Dreamdealer1-crypto/forceSensor_8x8/方案/8x8_压力矩阵_监工状态文档_v15.md

# 8×8织物压力矩阵逆向复现 —— 监工状态文档

> **唯一持续状态台账 / Single Source of Truth**  
> 监工：ChatGPT（GPT-5.6 Sol）  
> 执行者：Codex  
> 当前版本：v0.1  
> 当前日期：2026-08-15  
> 项目目标：先以8×8验证平台证实/证伪“阻性矩阵 + 零电位硬件解耦 + 每列TIA读出”路线，再对照原40×40样机，最终实现可证据闭环的100%复现。

---

## 1. 总体状态

**项目状态：IN PROGRESS**  
**当前阶段：ARCHITECTURE_EVALUATION —— 采集链已闭环，待稳定夹具复测 H1 传递函数**  
**当前结论等级：TIA / ADC3 / DMA / 软件采集链已验证正常；H1 失败归因于测试夹具接触不稳定，待稳定夹具复测。**

### 当前禁止事项
- 禁止直接进入STM32采集代码开发；
- 禁止接真实8×8传感器进行正式测试；
- 禁止改动已冻结4051控制引脚；
- 禁止改动ADC3八通道分配；
- 禁止把COL改接第二片4051；
- 禁止修改ROW 100 kΩ上拉、TIA Rf=10 kΩ、Cf=100 pF；
- 禁止未经监工批准更换VREF方案；
- 禁止在缺少RAW数据时仅凭热图宣布成功。

---

## 2. 当前冻结硬件基线

### STM32
- 主板：NUCLEO-H743ZI2
- MCU：STM32H743ZIT6
- ADC：ADC3单外设
- 调试串口：USART3 / ST-LINK VCP，初始115200 8N1

### 74HC4051（ROW）
- VCC → 3V3
- GND → GND
- VEE → GND
- Z / COM → GND
- S0 → PE14
- S1 → PE11
- S2 → PE9
- E / INH → **PG5**
- Y0~Y7 → ROW0~ROW7
- 每根ROW同时通过 **100 kΩ → VREF**

### VREF
- 3V3 → 2.2 kΩ → VREF
- VREF → 1 kΩ → GND
- VREF → 10 µF → GND
- VREF → 100 nF → GND
- 理论值约1.031 V
- 最终所有计算以实测VREF为准

### MCP6002 ×4（8路TIA）
每颗：
- Pin8 → 3V3
- Pin4 → GND
- Pin8/Pin4附近各自有100 nF去耦
- Pin3、Pin5 → VREF
- A路：Pin1 ↔ Pin2：10 kΩ ∥ 100 pF
- B路：Pin7 ↔ Pin6：10 kΩ ∥ 100 pF

### COL → ADC3固定映射
| COL | MCP6002输出 | STM32 | ADC3 |
|---|---|---|---|
| COL0 | U1 Pin1 | PF4 | INP9 |
| COL1 | U1 Pin7 | PF5 | INP4 |
| COL2 | U2 Pin1 | PF6 | INP8 |
| COL3 | U2 Pin7 | PF7 | INP3 |
| COL4 | U3 Pin1 | PF10 | INP6 |
| COL5 | U3 Pin7 | PC0 | INP10 |
| COL6 | U4 Pin1 | PC1 | INP11 |
| COL7 | U4 Pin7 | PC2 | INP12 |

---

## 3. 已知关键证据

### 原40×40系统
- 40×40阵列，80根经纬线独立引出；
- 原主控为STM32F407VET6；
- 上位机处理1600点矩阵；
- 原传感器ROW-COL之间外接标准电阻：
  - **10 kΩ：软件出现点**
  - **100 kΩ：软件点消失**

### 当前解释
该结果强烈支持“原系统对ROW-COL等效电导/阻抗变化敏感”，但**不能单凭该结果确认原系统就是纯电阻式或TIA读出**。软件阈值、基线或非线性映射仍可能参与。

---

## 4. Gate状态

| Gate | 内容 | 状态 | 关键证据 |
|---|---|---|---|
| H0 | 电源/VREF/TIA静态工作点 | **PASS** | 3V3=3.30V，VREF=1.03V，4颗MCP6002静态工作点用户报告正常 |
| H1 | 标准电阻传递函数 | **FAIL（归因测试夹具）** | 10k/22k有响应，47k/100k回VREF，R²=0.690449；已排除固件/DMA，待稳定夹具复测 |
| H2 | 4051 ROW扫描验证 | **PASS** | selected≈0V，unselected≈1.0V；偶发1.3V列为观察项 |
| ADC-01 | PF6 单通道 Polling | **PASS** | 1.143310 V，Rank1=Ch8，DMA=0 |
| ADC-02 | 8-rank Scan Polling | **PASS** | r3/c2=1.143634 V，SQR/PCSEL/DIFSEL 正确 |
| ADC-03A | 8-rank DMA 基线审计 | **NOT_REPRODUCED** | r3/c2=1.143236 V，read_before_tc=0，无 OVR/DMA 错 |
| H3 | 2×2有限电阻矩阵串扰A/B实验 | BLOCKED | 等H1/H2 PASS |
| H4 | 真实8×8传感器 | BLOCKED | 等H3 PASS |
| H5 | 参数优化 | BLOCKED | 等H4 PASS |
| O1 | 原40×40标准R扫值 | WAITING | 已有10k/100k两点证据 |
| O2 | 原40×40行列波形/模拟前端对照 | WAITING | 尚未测 |
| F1 | 40×40复刻设计 | BLOCKED | 必须等8×8与原机证据闭环 |

---

## 5. 当前第一道执行命令 —— 给Codex

### ORDER-001：H0静态硬件验收

**目的：在任何固件开发和传感器接入之前，证明模拟前端没有接线错误、饱和或VREF异常。**

### 执行要求
1. **不要接真实传感器。**
2. STM32仅上电，不要求先写扫描程序。
3. 使用万用表测量并记录：
   - STM32 3V3
   - VREF
   - U1 Pin3、Pin5
   - U2 Pin3、Pin5
   - U3 Pin3、Pin5
   - U4 Pin3、Pin5
   - U1 Pin1、Pin7
   - U2 Pin1、Pin7
   - U3 Pin1、Pin7
   - U4 Pin1、Pin7
4. 若有示波器，再观察：
   - VREF是否存在明显高频振荡；
   - 8个TIA输出是否存在振荡/贴轨。
5. 提交硬件照片，至少能看到：
   - 4051接线；
   - 4颗MCP6002；
   - 10k/100pF反馈；
   - VREF分压；
   - 每颗MCP6002的100nF去耦。

### 提交格式
Codex必须返回：

```text
ORDER-001 RESULT

3V3 = ___ V
VREF = ___ V

U1 Pin3 = ___ V
U1 Pin5 = ___ V
U1 Pin1 = ___ V
U1 Pin7 = ___ V

U2 ...
U3 ...
U4 ...

是否存在输出贴0V/3.3V：YES/NO
是否观察到明显振荡：YES/NO/未测

硬件照片：
<路径或附件>

异常：
<无 / 具体问题>
```

### H0 PASS条件
- 3V3正常；
- VREF约1.03 V且稳定；
- 所有MCP6002 Pin3/Pin5≈VREF；
- 无传感器输入时8个TIA输出均应位于VREF附近，不得长期贴0 V或3.3 V；
- 无明显短路、过热、异常电流或高频自激。

### H0 FAIL处理
若任一路异常：
- **停止后续开发；**
- 不允许通过软件滤波掩盖；
- 先由监工定位硬件问题并发出返工命令。

---

## 6. H0通过后的预定命令（尚未授权执行）

### ORDER-002：创建STM32工程
只有H0 PASS后下发：
- 固定GPIO；
- ADC3八通道regular sequence；
- USART3 VCP；
- 先做RAW输出；
- 不接真实传感器。

### ORDER-003：标准电阻传递函数
只有ORDER-002验收后下发：
- 10k、22k、47k、68k、100k、220k、470k、1M；
- 建立ADC/电压对1/R的传递函数；
- 验证平台是否能够稳定测R。

### ORDER-004：2×2零电位串扰A/B
只有H1/H2 PASS后下发：
- 有限非目标电阻；
- FLOAT vs 100k→VREF；
- 量化Kghost；
- 证实/证伪零电位解耦。

---

## 7. 监工判定原则

- “有数据” ≠ PASS；
- “能显示点” ≠ PASS；
- “热图看起来不错” ≠ PASS；
- 必须有RAW数据；
- 必须有对照组；
- 必须有重复性；
- 必须量化噪声/串扰；
- 必须区分硬件现象、固件处理和PC显示；
- 任何结论只能达到证据允许的强度。

---

## 8. 当前监工判断

### 技术判断
当前路线值得继续，但还没有证据证明：
- 原机一定使用TIA；
- 原机一定使用零电位法；
- 中间层一定是纯压阻；
- 8×8方案可以直接等比例扩展到40×40。

### 当前最高优先级
**先完成H0静态工作点验收。**

如果H0都不稳定，后面的ADC、算法、热图全部没有讨论价值。

---

## 9. 更新规则

今后每次Codex提交执行结果：
1. 监工先验收；
2. 给出 `PASS / FAIL / WAITING / 返工`；
3. 更新本文件Gate状态；
4. 记录关键证据；
5. 记录异常与风险；
6. 下发唯一下一条ORDER。

**未经监工验收，不跨Gate。**

---

## 10. 监工记录 #001 — Codex管理基线验收

**时间：2026-08-12 22:48 +08:00**  
**对应指令：ORDER-001**

### Codex提交
- Git仓库初始化完成；
- 管理基线提交：`3a3891c chore: initialize project management baseline`；
- `docs/STATUS.md` 已记录当前监工指令；
- `docs/DATA_MANAGEMENT.md` 已建立数据管理规范；
- `data/templates/gate_h0_static_measurement.csv` 已建立H0测量模板；
- 当前保持：不接真实传感器、不写扫描代码；
- Codex自报状态：`H0 WAITING_MEASUREMENT`。

### 监工验收
**管理动作：PASS**  
**H0 Gate：仍为 WAITING_MEASUREMENT**

理由：
- Codex没有越过Gate；
- 没有提前写扫描代码；
- 没有接真实传感器；
- 已建立可追溯的数据与状态管理基础；
- 但ORDER-001的核心证据——实际静态电压测量——尚未提交，因此不能判定H0 PASS。

### 当前唯一允许执行的下一步

#### ORDER-001A：完成H0静态测量
必须实测并提交：
- 3V3；
- VREF；
- U1 Pin3、Pin5、Pin1、Pin7；
- U2 Pin3、Pin5、Pin1、Pin7；
- U3 Pin3、Pin5、Pin1、Pin7；
- U4 Pin3、Pin5、Pin1、Pin7。

同时记录：
- 是否有任一路输出贴近0 V；
- 是否有任一路输出贴近3.3 V；
- 是否有芯片异常发热；
- 若有示波器，记录VREF和任一TIA输出是否存在明显振荡。

### 禁止事项继续有效
在ORDER-001A验收前：
- 禁止创建ADC3扫描逻辑；
- 禁止创建4051轮询扫描逻辑；
- 禁止接真实8×8传感器；
- 禁止调整Rf/Cf/VREF/ROW上拉参数；
- 禁止更改冻结引脚。

### 下一Gate条件
只有当ORDER-001A数据通过监工验收后，才允许下发：
`ORDER-002：STM32工程 + 4051 GPIO + ADC3八通道RAW采集`

---

## 11. 监工记录 #002 — H0静态工作点验收

**时间：2026-08-12 23:04 +08:00**  
**对应指令：ORDER-001A**

### 用户实测
- 3V3 = **3.30 V**
- VREF = **1.03 V**
- U1 Pin3 / Pin5 / Pin1 / Pin7：用户报告 **正常**
- U2 Pin3 / Pin5 / Pin1 / Pin7：用户报告 **正常**
- U3 Pin3 / Pin5 / Pin1 / Pin7：用户报告 **正常**
- U4 Pin3 / Pin5 / Pin1 / Pin7：用户报告 **正常**

### 监工判定
**H0：PASS**

判定依据：
- 3V3符合预期；
- VREF与理论1.031 V高度一致；
- 4颗MCP6002的正输入与输出均未报告贴轨、异常或明显故障；
- 已满足进入数字控制与ADC RAW采集阶段的最低硬件条件。

### 证据质量备注
用户未逐路给出8个TIA输出的具体数值，因此本次H0属于“功能性PASS”。  
后续ORDER-002在ADC3 RAW采集时必须补回8路空载基线数值，以再次确认所有TIA输出确实位于合理工作点。

---

## 12. 当前执行命令 —— ORDER-002

### 目标
建立最小STM32固件，只验证：
1. 4051行选择；
2. ADC3八通道RAW采集；
3. 串口原始输出；
4. 不接真实传感器；
5. 不做压力换算、不做滤波、不做热图。

### Codex必须执行

#### A. GPIO
固定：
- S0 = PE14
- S1 = PE11
- S2 = PE9
- E  = PG5

要求：
- Push-Pull Output
- 初始 `E=1`（4051关闭）
- 提供 `row_select(uint8_t row)` 函数
- 切换流程必须：`E=1 → 写S0/S1/S2 → 短延迟 → E=0`

#### B. ADC3
固定8个输入，Rank顺序必须严格为COL0→COL7：
1. PF4  / ADC3_INP9
2. PF5  / ADC3_INP4
3. PF6  / ADC3_INP8
4. PF7  / ADC3_INP3
5. PF10 / ADC3_INP6
6. PC0  / ADC3_INP10
7. PC1  / ADC3_INP11
8. PC2  / ADC3_INP12

要求：
- 仅使用ADC3；
- Regular Sequence 8 ranks；
- DMA；
- 首版采用保守采样时间；
- 上电执行ADC校准；
- 首版软件触发；
- 禁止启用复杂数字滤波/oversampling以免掩盖模拟问题。

#### C. 扫描时序
首版：
- `T_SETTLE_US = 500`
- 每个ROW：
  - 选择ROW
  - 等待500 µs
  - 做1次8通道dummy scan并丢弃
  - 再做16次8通道scan
  - 计算每列平均RAW ADC
- 扫完8行后 `E=1`

#### D. 串口
优先USART3 / ST-LINK VCP：
- 115200
- 8N1

每帧文本输出：
`FRAME,<seq>,<timestamp_us>`
然后：
`R0,c0,c1,c2,c3,c4,c5,c6,c7`
...
`R7,c0,c1,c2,c3,c4,c5,c6,c7`
最后：
`END`

禁止当前阶段输出“压力值”。

### ORDER-002验收前禁止
- 禁止接真实8×8传感器；
- 禁止做H1标准电阻；
- 禁止改Rf/Cf/VREF；
- 禁止改GPIO/ADC3 pin map；
- 禁止加入热图或阈值算法。

### Codex提交必须包含
1. Git commit hash；
2. `.ioc`；
3. GPIO配置；
4. ADC3 Rank 1~8配置；
5. ADC分辨率与sampling time；
6. DMA配置；
7. 编译日志；
8. 烧录日志；
9. 串口至少连续5帧RAW输出；
10. 8路空载ADC基线均值与标准差。

### ORDER-002判定
- GPIO、ADC3、DMA、UART均按冻结方案：必要条件；
- 8路数据顺序稳定，无通道丢失；
- ADC无固定0/满量程异常；
- 8路空载RAW能对应到合理的TIA静态工作点；
- 连续帧无明显错位/丢列。

满足后才允许进入H1标准电阻传递函数。

---

## 13. 监工记录 #003 — ORDER-002 固件与空载ADC验收

**时间：2026-08-12 23:20 +08:00**  
**Codex提交 commit：`996390cbc553ba3c0314e55ea963786c3f1bd5e7`**

### 交付物
- `.ioc`：`firmware/8x8_resist_matrix_minimal.ioc`
- 主程序：`firmware/Core/Src/main.c`
- 构建日志：`reports/logs/2026-08-12_order-002_build.log`
- 烧录日志：`reports/logs/2026-08-12_order-002_flash.log`
- 5帧RAW串口：`data/raw/2026-08-12_order-002_raw_uart_5frames_run01.log`
- ADC统计：`data/analysis/2026-08-12_order-002_unloaded_adc_stats_run01.csv`
- 监工回复：`reports/supervisor/2026-08-12_order-002_minimal-firmware-result.md`

### 固件配置核对
- GPIO：S0=PE14，S1=PE11，S2=PE9，E=PG5；
- ADC3单外设；
- Rank 1~8严格对应COL0~COL7；
- 16-bit ADC；
- Sampling time = `ADC_SAMPLETIME_64CYCLES_5`；
- DMA1_Stream1 / DMA_REQUEST_ADC3 / DMA_NORMAL / halfword；
- USART3 = 115200 8N1；
- `T_SETTLE_US = 500`；
- 每ROW：1次dummy + 16次平均；
- 未接真实传感器；
- 未做热图和压力换算。

### 构建与运行
- Build：PASS；
- Flash：PASS；
- 串口：FRAME 0~4正常输出。

### 空载ADC统计
| COL | mean[count] | std[count] | 按3.3V满量程估算均值[V] | 估算噪声σ[mV] |
|---|---:|---:|---:|---:|
| COL0 | 20612.025 | 16.318 | 1.0379 | 0.82 |
| COL1 | 20622.950 | 28.258 | 1.0385 | 1.42 |
| COL2 | 20879.750 | 67.457 | 1.0514 | 3.40 |
| COL3 | 20751.750 | 31.360 | 1.0449 | 1.58 |
| COL4 | 20600.375 | 37.626 | 1.0373 | 1.89 |
| COL5 | 20628.625 | 20.656 | 1.0387 | 1.04 |
| COL6 | 20607.150 | 23.996 | 1.0377 | 1.21 |
| COL7 | 20615.750 | 22.663 | 1.0381 | 1.14 |

> 电压换算只用于工程判断，按ADC参考约3.3V估算；正式标定仍需使用实测参考。

### 监工分析
1. 8路均处在约1.04V附近，与实测VREF=1.03V一致，没有贴0V或3.3V，说明TIA静态工作点整体合理。
2. ADC3八通道、DMA、USART3及数据顺序已具备继续实验的基础。
3. COL2为当前异常关注通道：
   - 均值较其他通道高约13mV；
   - 标准差约3.4mV，为8路最大；
   - 目前不判FAIL，但必须在标准电阻实验中重点观察是否为固定通道噪声/接线问题。
4. 当前数据只能证明ADC/TIA空载链路基本可用，**不能证明4051实际选中ROW已经被正确拉到GND、未选中ROW被100k稳定在VREF**。
5. 因此ORDER-002的软件部分通过，但H2电气ROW扫描证据尚缺。

### 监工判定
- **C0/C2 最小固件与ADC RAW采集：PASS**
- **H2 4051 ROW电气扫描：WAITING_MEASUREMENT**
- **H1 标准电阻传递函数：仍 BLOCKED**

---

## 14. 当前唯一执行命令 —— ORDER-002A

### 目的
补齐4051实际电气动作证据，防止“代码在切ROW，但硬件ROW没有按预期到0V/VREF”。

### 执行方式
Codex增加一个**仅用于H2验证的静态/慢速ROW测试模式**：

- 每2秒切换一次ROW；
- 串口打印当前ROW编号；
- 顺序ROW0→ROW7循环；
- 其余ADC逻辑不改；
- 不接真实传感器。

用户用万用表或示波器测：
1. 当前被选中的ROW电压；
2. 任意一个未被选中的ROW电压。

至少记录：
- ROW0被选中时：ROW0、ROW1；
- ROW1被选中时：ROW1、ROW0；
- ROW7被选中时：ROW7、ROW0。

### 预期
- selected ROW：明显接近0V；
- unselected ROW：明显接近VREF≈1.03V。

### 提交
Codex/用户提交：
```text
ROW0 selected:
  ROW0 = __ V
  ROW1 = __ V

ROW1 selected:
  ROW1 = __ V
  ROW0 = __ V

ROW7 selected:
  ROW7 = __ V
  ROW0 = __ V
```

如果有示波器，补一张ROW切换波形。

### Gate
- 若selected≈0V、unselected≈VREF：H2 PASS，授权H1；
- 若不符合：H2 FAIL，先修4051/ROW网络，不得进入标准电阻实验。

---

## 15. 监工记录 #004 — H2 4051 ROW电气扫描验收

**时间：2026-08-12 23:35 +08:00**

### 用户实测
- ROW0 selected：
  - ROW0 ≈ 0 V
  - ROW1 ≈ 1.0 V
- ROW1 selected：
  - ROW1 ≈ 0 V
  - ROW0 ≈ 1.0 V
- ROW7 selected：
  - ROW7 ≈ 0 V
  - ROW0 ≈ 1.0 V

补充现象：
- 未选中ROW大部分时间约1.0 V；
- 偶尔观察到约1.3 V；
- 当前测量为大概值，未使用示波器做瞬态捕获。

### 监工判定
**H2：PASS（带观察项）**

依据：
- selected ROW稳定表现为约0 V；
- unselected ROW大部分时间接近VREF≈1.03 V；
- 说明4051选择逻辑、Z→GND和ROW 100 kΩ→VREF拓扑整体按预期工作。

### 观察项
偶发约1.3 V暂不阻塞：
- 可能来自切换瞬态、数字万用表采样/保持方式、寄生电容或VREF局部动态；
- 后续如果标准电阻实验出现明显离散、过冲或通道相关异常，再要求示波器测ROW切换波形。

### Gate变化
- H2：PASS
- H1：AUTHORIZED

---

## 16. 当前执行命令 —— ORDER-003：标准电阻传递函数

### 目的
验证整个链路：
`ROW选择 → 标准R → COL TIA → ADC3 → RAW`

是否能稳定、单调、可定量地测量已知电阻。

### 硬件
- **仍然不接真实8×8传感器。**
- 在 `ROW0 ↔ COL0` 之间接标准电阻。
- 其他ROW/COL不额外接矩阵电阻，保持当前硬件基线不变。

### 标准阻值
依次：
- 10 kΩ
- 22 kΩ
- 47 kΩ
- 68 kΩ
- 100 kΩ
- 220 kΩ
- 470 kΩ
- 1 MΩ

若有4.7 kΩ，可附加测试是否进入饱和，但不纳入主拟合。

### 每个阻值
- 连续采集至少100帧；
- 保存完整RAW；
- 重点提取 `R0,C0`；
- 同时记录其余63点，作为异常/鬼影参考，但本Gate不以鬼影为主要结论；
- 记录实测VREF。

### Codex必须输出
文件：
- `data/raw/...order-003_<R>_run01.log`
- `data/analysis/...order-003_transfer.csv`
- `reports/...order-003_transfer_result.md`
- 至少一张 `ΔV vs 1/R` 拟合图

统计字段至少包含：
- R_test_ohm
- raw_mean
- raw_std
- vout_mean_v
- delta_v = vout_mean - VREF
- inv_r
- theoretical_delta_v
- relative_error
- saturated
- R²（只对未饱和有效区拟合）

### 理论基线
当前：
- VREF ≈ 1.03 V
- Rf = 10 kΩ

理想：
`ΔV ≈ VREF × Rf / Rtest`

预期量级：
- 10 kΩ：ΔV≈1.03 V
- 22 kΩ：≈0.47 V
- 47 kΩ：≈0.22 V
- 100 kΩ：≈0.10 V
- 220 kΩ：≈47 mV
- 470 kΩ：≈22 mV
- 1 MΩ：≈10 mV

### PASS判据
强PASS：
- 10 kΩ~220 kΩ范围严格单调；
- 不出现随机0/满量程跳变；
- `ΔV vs 1/R` 的 R² ≥ 0.995；
- 10 kΩ~220 kΩ整体理论偏差≤5%为优良；
- 470 kΩ / 1 MΩ主要用于评估高阻区噪声，不以5%作为硬性门槛。

### 特别观察
- COL2此前空载std最高，本轮同时观察其余通道是否仍存在异常噪声；
- 若R0C0标准R数据正常而其他通道噪声不影响测量，不阻塞；
- 若标准R本身无法形成稳定单调传递函数，H1直接FAIL，不得接真实传感器。

---

## 17. 监工记录 #005 — ORDER-003 Run01 失败与加速返工方案

**时间：2026-08-13 00:12 +08:00**

### Codex提交
ORDER-003 Run01结果：`FAIL_REWORK_REQUIRED`

关键数据：
- 10k：Vout≈1.03797 V，理论≈2.06 V
- 22k：Vout≈1.03779 V
- 47k：Vout≈1.03794 V
- 68k：Vout≈1.03777 V
- 100k：Vout≈1.03782 V
- 220k：Vout≈1.03808 V
- 470k：Vout≈1.03803 V
- 1.5M：Vout≈1.03793 V
- 全阻值几乎不随R变化，说明标准R没有进入有效TIA电流路径。
- 1M缺失改用1.5M：**允许**。
- 10k/22k只有99帧：记录为次要问题，不是本轮失败主因。

### 监工判定
**H1：FAIL — 原因定位阶段**
不是算法问题，也不是采样帧数问题。
当前最可能为：
1. ROW0/COL0物理节点接错；
2. COL0没有接到U1 Pin2；
3. TIA反馈路径断路/接错；
4. 标准R没有真正跨接“0V选中ROW ↔ VREF虚地COL”。

### 加速原则
由于用户次日有紧急汇报，停止完整8阻值扫值，改为最小故障树。
只做能最大化信息增益的测试，不做重复性和完整统计。

---

## 18. 当前执行命令 —— ORDER-003A FAST DEBUG

### 目标
在最少手工测量下，今天内判断故障位于：
- TIA本身；
- COL0映射；
- ROW0/4051路径。

### Codex动作
增加一个 `FAST_DEBUG_ROW0` 模式：
- 4051固定选择ROW0；
- E保持有效；
- 不进行8行轮询；
- ADC3仍持续采8路；
- USART3每100ms打印一次8路RAW；
- 不做平均以外的算法处理。

### 用户只需做两步

#### FAST-A：绕过ROW/4051，直接验证TIA
不接真实传感器。

将 **10 kΩ** 直接接在：
- 一端：`U1 Pin2 / COL0 TIA反相输入节点`
- 另一端：`GND`

预期：
- U1 Pin1 / COL0 ADC输出应从约1.03 V升到约2.06 V；
- ADC COL0应显著升高；
- 其他COL基本不变。

判定：
- 若成立 → TIA0与ADC COL0链路PASS，故障在ROW0/4051/物理节点映射；
- 若不成立 → TIA0接线/反馈/ADC映射有问题，停止后续。

#### FAST-B：验证ROW0路径
只有FAST-A PASS后：
- 移除“COL0→10k→GND”
- 改为 `ROW0 ↔ 10 kΩ ↔ COL0`
- 运行固定ROW0模式

预期：
- U1 Pin1仍应约2.06 V；
- 若FAST-A PASS但FAST-B FAIL，则问题锁定在ROW0物理线、Y0/4051或ROW0标识。

### 今天若FAST-A/B都PASS
立即做最小4点传递函数：
- 10k
- 22k
- 47k
- 100k

每点只需30帧。
目标只证明：
- 单调；
- 数量级合理；
- 与1/R趋势一致。

这4点足够用于次日阶段汇报，但不得宣称完成完整H1。

### 汇报可用结论
截至当前可安全汇报：
1. 已完成8×8零电位/TIA采集平台硬件；
2. H0电源与8路TIA静态工作点通过；
3. 4051行选择：selected≈0V，unselected≈1.0V，H2通过；
4. ADC3八通道DMA与串口RAW链路通过；
5. 空载8路输出约1.04V，噪声约0.8~3.4mV RMS；
6. 首轮标准R实验失败，但失败模式非常明确：输出完全不随R变化，已排除“只是噪声太大”，当前在定位物理路径；
7. 当前已建立最小故障树FAST-A/B，可在不接真实传感器情况下区分TIA故障与ROW/4051映射故障。

### Gate状态
- H0：PASS
- H2：PASS
- H1：FAIL_REWORK
- H3/H4：BLOCKED

---

## 19. 监工记录 #006 — ORDER-003A FAST-A 验收

**时间：2026-08-13 00:22 +08:00**  
**Codex commit：`318bfc8438c9477ad5516f09417ece6b73802958`**

### FAST-A条件
- 固定ROW0；
- 10 kΩ直接跨接 `U1 Pin2 / COL0 TIA反相输入 ↔ GND`；
- 绕过4051/ROW物理路径；
- 未接真实传感器；
- ADC3每100 ms输出8路RAW。

### 实测
- COL0 mean = 38215.75 raw
- 按3.3 V满量程估算：Vout ≈ 1.924 V
- 原空载：≈1.038 V
- 实际输出变化：ΔV ≈ 0.886 V

### 监工判定
**FAST-A：PASS**

已确认：
1. U1A TIA能够响应外部电阻电流；
2. COL0 → ADC3 Rank1链路正常；
3. ORDER-003 Run01的“全阻值平坦”不是因为COL0 ADC死通道；
4. 故障范围已显著收缩到ROW0/4051/物理ROW-COL接点或标准电阻接入位置。

### 精度观察项
理论理想值约2.06 V，实际约1.924 V，低约0.14 V（约13%增量误差）。

当前不阻塞FAST-B，原因：
- FAST-A的目标是验证TIA/ADC链路是否有效，已经明确有效；
- 当前阶段更优先定位ORDER-003为什么完全没有响应。

后续H1重新执行前必须核对：
- FAST-A用10 kΩ实测阻值；
- U1A反馈电阻Rf实测阻值；
- FAST-A状态下U1 Pin2实际电压；
从而解释理论与实测约13%的差异。

### Gate状态
- FAST-A：PASS
- FAST-B：AUTHORIZED
- H1：仍 FAIL_REWORK

---

## 20. 当前执行命令 —— ORDER-003B FAST-B

### 目标
验证真实 `ROW0 → 标准R → COL0/TIA` 路径。

### 接线
1. 移除 FAST-A 的 `COL0 → 10 kΩ → GND`；
2. 保持FAST_DEBUG_ROW0固件；
3. 将同一颗10 kΩ改接：
   `ROW0 ↔ 10 kΩ ↔ COL0`
4. 不接真实传感器。

### 采集
- 采10~20秒FAST RAW即可；
- 记录COL0 mean；
- 用户无需重复测所有节点。

### 判定
#### 情况A：COL0再次升至约FAST-A同一量级（约1.9 V）
**FAST-B PASS**
说明：
- ROW0实际节点；
- 4051 Y0→GND路径；
- ROW0到COL0标准电阻路径；
均已工作。
则ORDER-003 Run01大概率是当时标准R接点/物理节点识别错误或采集时ROW映射未固定导致。

下一步直接做加速4点H1：
`10k / 22k / 47k / 100k`，每点30帧。

#### 情况B：COL0仍约1.03 V
**FAST-B FAIL**
说明故障锁定于：
- ROW0物理节点不是当前以为的ROW0；
- 10k没有真正接在ROW0-COL0之间；
- ROW0到4051 Y0路径存在接点问题。

此时只要求用户做一个手工测量：
FAST-B连接状态、ROW0固定选中时，测10k两端电压。
- 若一端≈0 V、另一端≈1.03 V：电阻路径存在，应检查COL0实际节点；
- 若两端都≈1 V：ROW0接点错；
- 若两端都≈0 V：COL0接点错/被错误接地。

---

## 21. 监工记录 #007 — FAST-B 失败，故障进一步锁定

**时间：2026-08-13 00:27 +08:00**

### 新信息
用户确认ORDER-003首次测试时曾把逻辑ROW0误接到物理ROW7，现已纠正。

纠正后FAST-B：
- 固件：FAST_DEBUG_ROW0，固定选择ROW0；
- 接线：`ROW0 ↔ 10 kΩ ↔ COL0`
- COL0 mean = 20626.606 raw
- Vout ≈ 1.038648 V
- 与空载≈1.038 V基本一致。

### 监工判定
**FAST-B：FAIL**

结合FAST-A已经PASS：
- 直接 `U1 Pin2 ↔ 10k ↔ GND` 时，U1 Pin1明显升至≈1.924 V；
- 因此U1A TIA和ADC3 COL0链路正常；
- FAST-B仍无响应，说明“物理COL0接点”或“ROW0到电阻的实际接点”至少有一侧没有真正形成 `0V ↔ 10k ↔ U1 Pin2` 路径。

### 当前最高概率故障
**优先怀疑物理COL0接点并未真正与U1 Pin2导通。**

理由：
- FAST-A直接使用U1 Pin2时链路有效；
- FAST-B使用名为COL0的外部接点时链路失效；
- 若ROW0确实被4051拉到0V且COL0确实就是U1 Pin2，则FAST-B电气上应与FAST-A近似等价，不应完全无响应。

### 当前唯一手工检查 —— ORDER-003C
断电后只做一次万用表蜂鸣/电阻档连续性检查：

1. **物理COL0接点 ↔ U1 Pin2**
2. **物理ROW0接点 ↔ 74HC4051 Y0**

提交：
```text
COL0 -> U1 Pin2: 导通 / 不导通 / 阻值___Ω
ROW0 -> 4051 Y0: 导通 / 不导通 / 阻值___Ω
```

不要求再测电压，不要求重新扫电阻。

### 判定逻辑
- COL0→U1 Pin2不导通：直接找到主故障，修线后重做FAST-B；
- ROW0→Y0不导通：修ROW0路径后重做FAST-B；
- 两条都导通：再进入下一步“FAST-B状态下测10k两端电压”，但现在先不增加用户手工工作。

### 当前Gate
- H0：PASS
- H2：PASS（但ROW0物理映射曾发生一次人为接错，已记录）
- FAST-A：PASS
- FAST-B：FAIL
- H1：FAIL_REWORK
- H3/H4：BLOCKED

---

## 22. 监工记录 #008 — 连续性检查确认主故障

**时间：2026-08-13 00:40 +08:00**

### 用户实测
- 物理ROW0 → 74HC4051 Y0：**导通**
- 物理COL0 → U1 Pin2：**约0.24 MΩ（240 kΩ）**

### 监工判定
**主故障已基本锁定：物理COL0没有直接连到U1 Pin2。**

如果COL0与U1 Pin2按设计属于同一个电气节点，断电电阻应接近导线/接触电阻量级，而不应为约240 kΩ。

这与前面两组实验完全一致：
- FAST-A直接在U1 Pin2接10k到GND → TIA明显响应；
- FAST-B通过“物理COL0”接ROW0→10k→COL0 → 无响应；
- 连续性检查显示物理COL0到U1 Pin2只有约240k等效路径。

因此ORDER-003 Run01平坦的主要原因已经有直接硬件证据支持：**标准电阻没有真正接入COL0 TIA反相输入节点。**

### 当前执行命令 —— ORDER-003D：修复COL0物理连接

要求：
1. 断电；
2. 检查并修复“物理COL0接点 → U1 Pin2”的导线/面包板节点；
3. 修复后再次用电阻档确认：
   - `COL0 → U1 Pin2` 应接近0Ω，至少必须从240kΩ降到导线连接量级；
4. 不改任何其他硬件参数；
5. 修复后直接重跑FAST-B：
   - `ROW0 ↔ 10k ↔ COL0`
   - 固定ROW0
   - 采5~10秒即可。

### FAST-B重测PASS预期
- COL0 RAW从空载约20600显著上升；
- U1 Pin1应进入约1.9~2.1V量级；
- 若恢复明显响应，则正式确认本轮故障为COL0物理连接问题。

### Gate
- H0：PASS
- H2：PASS
- FAST-A：PASS
- FAST-B：FAIL（已定位主因）
- H1：REWORK_IN_PROGRESS

---

## 23. 监工记录 #009 — FAST-B 修复后复测通过

**时间：2026-08-13 00:49 +08:00**  
**Codex commit：`9289a1e71e9c1acbb64086659eb175a08953de9e`**

### 修复后FAST-B实测
条件：
- 固定选择ROW0；
- `ROW0 ↔ 10 kΩ ↔ COL0`；
- 未接真实传感器；
- COL0已修复为与U1 Pin2直接导通。

结果：
- COL0 mean = **38223.725 raw**
- COL0 voltage ≈ **1.924747 V**
- COL0 std = **74.986 raw**
- 样本数 = **142**
- 按3.3 V / 16-bit估算，std约 **3.78 mV**

### 与FAST-A对照
FAST-A：
- 10 kΩ直接 `U1 Pin2 ↔ GND`
- Vout ≈ **1.924 V**

修复后的FAST-B：
- 10 kΩ经 `ROW0 ↔ COL0`
- Vout ≈ **1.9247 V**

两者高度一致。

### 监工判定
**FAST-B：PASS**

并正式确认ORDER-003 Run01失败的主因：

> **物理COL0与U1 Pin2之间连接错误/高阻连接，导致标准电阻没有真正进入TIA输入电流路径。**

证据链：
1. FAST-A绕过ROW/COL外部节点时TIA明显响应；
2. 物理COL0→U1 Pin2曾测得约240 kΩ，明显异常；
3. 修复后FAST-B立即恢复到与FAST-A几乎相同的1.924 V；
4. 因此故障根因已经闭环，不再属于“推测”。

### 当前Gate
- H0：PASS
- H2：PASS
- FAST-A：PASS
- FAST-B：PASS
- H1：**RETEST_AUTHORIZED**
- H3/H4：仍BLOCKED

---

## 24. 当前执行命令 —— ORDER-003E：加速4点传递函数

### 目的
在用户次日汇报前，用最小时间取得可展示的电阻-响应趋势证据。

### 固件
继续使用已验证链路。
可恢复正常ROW扫描，也可固定ROW0；为了减少变量，**本轮优先固定ROW0**。

### 阻值
只测：
- 10 kΩ
- 22 kΩ
- 47 kΩ
- 100 kΩ

### 每点采集
- 至少30个有效样本；
- 建议50个，若时间允许；
- 不要求100帧；
- 保存RAW。

### 必须输出
每个阻值：
- sample_count
- mean_raw
- std_raw
- mean_voltage
- `ΔV = Vout - 实测VREF`

并生成一张最简图：
- X轴：`1/R`
- Y轴：`ΔV`
- 线性拟合R²

### 加速PASS条件
本轮为“阶段汇报PASS”，不是完整H1最终PASS：
1. 10k、22k、47k、100k响应严格单调；
2. `ΔV`随`1/R`明显近似线性；
3. R² ≥ 0.98 可用于阶段汇报；
4. 无任何一点退回空载≈1.038 V而失去响应；
5. 原始数据与图必须保留。

若R² ≥ 0.995，则可记为强PASS候选，但完整H1仍建议后续补220k/470k/1.5M。

### 次日汇报允许表述
若ORDER-003E通过，可安全表述：

> 已完成8×8压力矩阵模拟采集原型的基础链路验证。零电位行选择、8路TIA和ADC3采集均已跑通；调试中定位并修复一处COL0高阻接线故障。修复后10 kΩ标准负载在ROW路径和直接TIA路径下均得到约1.925 V的一致输出，证明ROW→电阻→COL→TIA→ADC链路已经闭环。进一步通过4个标准电阻点验证输出对电导变化的单调响应。

禁止表述：
- “已经复现原40×40系统”；
- “已证明原机采用零电位法”；
- “真实织物8×8已经通过”；
- “多点串扰已经解决”。

---

## 25. 监工记录 #010 — ORDER-003E失败，但批准“0→1压力识别演示支线”

**时间：2026-08-13 01:08 +08:00**  
**Codex commit：`81d2f42c95260fe396c14fb421eb9818a34f1517`**

### ORDER-003E结果
| R | mean RAW | Vout | ΔV |
|---|---:|---:|---:|
| 10 kΩ | 38220.380 | 1.924579 V | 0.894579 V |
| 22 kΩ | 37872.000 | 1.907036 V | 0.877036 V |
| 47 kΩ | 20618.500 | 1.038240 V | 0.008240 V |
| 100 kΩ | 20611.320 | 1.037878 V | 0.007878 V |

`ΔV vs 1/R`: R² = **0.690449**

### 监工判定
**H1完整传递函数：FAIL，继续保留为技术债。**

当前异常：
- 10k与22k均有明显响应；
- 47k及100k基本回到VREF；
- 10k与22k输出又过于接近；
- 因此当前模拟链还不能用于“定量测电阻/定量压力”。

但用户当前目标改为：
> 今晚优先完成一次从“真实压力输入 → 8×8扫描 → RAW变化 → 位置识别/热图”的0→1闭环；精度和定量问题后续再修。

### 监工决策
**批准开启 DEMO 支线，不改变H1 FAIL事实。**

此支线只允许验证：
- 是否检测到压力；
- 是否能定位到大致ROW/COL；
- 是否能实时显示相对压力变化。

禁止借此宣称：
- 完成压力标定；
- 压力值单位为N/kPa；
- 已解决串扰；
- 已完成原40×40复现；
- 已证明10k~100k完整线性响应。

---

## 26. 当前执行命令 —— ORDER-DEMO-001：真实8×8压力识别0→1

### 目标
今晚优先打通：

`真实8×8传感器 → ROW扫描 → 8路TIA → ADC3 → 64像素RAW → baseline subtraction → press detection → 8×8 heatmap`

### 硬件
- 允许首次接入真实8×8传感器；
- ROW0~ROW7 → 已验证4051 Y0~Y7；
- COL0~COL7 → 8路TIA；
- 不修改VREF / 100k ROW bias / Rf / Cf / ADC pin map。

### 固件
恢复8行扫描：
- `T_SETTLE_US = 500`
- 每ROW：1次dummy + 8次平均即可（从16降到8，优先帧率）
- 形成 `uint16_t frame[8][8]`
- 串口输出完整64点RAW

本轮不做压力物理单位换算。

### PC端最小算法

#### 1. Baseline
启动后无压力采集100帧：
- 每像素 `baseline_mean[r][c]`
- 每像素 `baseline_std[r][c]`

#### 2. Delta
当前像素：
`delta[r][c] = raw[r][c] - baseline_mean[r][c]`

由于当前标准电阻实验显示导通增强会使TIA输出上升，因此演示版先只保留正向delta。

#### 3. 阈值
每像素阈值：
`threshold[r][c] = max(8 * baseline_std[r][c], 300 ADC counts)`

判定：
`pressed = delta > threshold`

如果真实传感器响应明显但方向相反，Codex不得自行重写理论；只需记录并把demo算法改成`abs(delta)`，同时提交监工备注。

#### 4. 相对强度
仅用于热图显示：
`score = max(delta - threshold, 0)`

热图可以每帧动态归一化到0~1。
该值只能称为：
- relative pressure response
- relative intensity
不能称为N、kPa。

### 最小用户操作
只需要：
1. 无压力静置5秒；
2. 用手指按一个明确交叉点3~5秒；
3. 松开；
4. 再按另一个相距较远的点3~5秒。

不要求今晚做砝码标定、多点串扰、重复性10次。

### Codex必须产出
- 一份64点RAW日志；
- baseline CSV；
- 至少一段“无压→按压→松开”的时间序列；
- 8×8 delta heatmap；
- 自动输出：
  - `max_row`
  - `max_col`
  - `max_delta`
  - `pressed_pixel_count`
- 若能实时刷新，则做一个最简实时heatmap窗口。

### DEMO PASS条件
满足以下即可认为“今晚0→1闭环打通”：
1. 无压时绝大多数像素保持阈值以下；
2. 按压时至少一个像素明显超过基线噪声；
3. 最大响应位置与实际按压位置大致一致（允许±1格）；
4. 松开后响应明显回落；
5. 第二个位置能使最大响应位置发生相应移动。

### DEMO PARTIAL PASS
如果：
- 能检测按压/松开；
- 但位置有明显串扰或偏移；
则记：
**DEMO PARTIAL PASS — pressure detection works, localization pending**。

### DEMO FAIL
若真实传感器按压时64点均没有超过基线噪声：
- 不再耗时调软件；
- 记录为“当前真实传感器等效阻抗可能落在现有前端不可见区间”；
- 后续回H1/H4调Rf/VREF/传感器接触路径。

---

## 27. 当前Gate状态更新

- H0：PASS
- H2：PASS
- H1：FAIL（技术债，未解决）
- H3：BLOCKED
- H4正式验证：BLOCKED
- **DEMO-0→1：AUTHORIZED**
- 40×40复刻：BLOCKED

### 当前最高优先级
**不再做更多标准电阻手工测量，先用真实传感器判断“有没有可用压力信号”。**

---

## 30. 监工记录 #012 — 暂停实验，进入架构复盘

**时间：2026-08-14 23:35 +08:00**

### 状态变更
用户要求停止“为了展示而加速”的路线，重新从系统机理与硬件架构层面复盘。

**项目总状态：PAUSED_ARCHITECTURE_REVIEW**

在架构复盘完成前：
- 暂停新的真实传感器压力演示；
- 暂停继续调整软件阈值/热图；
- 暂停用算法解释 RELEASE 不回零、固定 R5/C2 热点；
- 暂停扩展到40×40；
- 保留现有硬件，不立即拆改，作为对照样机。

### 新参考文献
Johnson et al., *Scaling Fabric-Based Piezoresistive Sensor Arrays for Whole-Body Tactile Sensing*.

文献中的传感器物理结构与当前目标高度相似：中央压阻织物层，上下两组正交导电条，每个交叉点形成taxel；压力使交叉点等效体电阻下降，逐行施加已知电压并从列侧读取电流。

### 架构复盘发现
当前v1.0验证板并不是文献零电位架构的等价实现。

文献架构：
- 活动ROW通过低Ron SPDT主动接3.3V；
- 所有未活动ROW通过独立SPDT主动、低阻接GND；
- 被测COL通过输出MUX接TIA；
- TIA反相端维持接近0V的virtual ground；
- TIA后增加第二级反相以匹配ADC正输入范围；
- Rf可调；
- 行开关Ron约0.35Ω，输出MUX Ron约0.5Ω/2.5Ω；
- 串扰抑制依赖“inactive rows硬接地 + selected column虚地”。

当前v1.0：
- 活动ROW通过74HC4051接GND；
- 未活动ROW仅通过100k接VREF≈1.03V；
- 8个COL全部各自接TIA并维持在VREF附近；
- 固定Rf=10k；
- 单电源MCP6002；
- 8列并行读取。

### 监工结论
两者虽然都属于电位控制 + TIA读出，但电流路径、未选中节点阻抗、行负载、串扰机制和动态范围都不同。

因此：不能再把当前v1.0板称为对文献“零电位法”的直接验证，也不能用其失败/成功直接推断原40×40系统。

### 下一Gate
**ARCH-01：先完成“文献架构 vs 当前v1.0 vs 原40×40”三方对照和最小验证计划。**

在ARCH-01通过前，不下发新的Codex硬件修改ORDER。

---

## 31. 监工记录 #013 — 项目目标重新定义：以可行方案为主，原机为高价值基线

**时间：2026-08-14 23:45 +08:00**

### 用户重新定义最终目标
项目的首要目标不是机械地“逐项100%复刻原机电路”，而是：

> **验证并建立一套真正可行、稳定、可解释、可扩展的压力矩阵采集方案。**

原机逆向的价值在于：
- 提供已经被实际验证过的baseline；
- 帮助识别矩阵传感器真正需要解决的问题；
- 提取其有效电路机制、扫描策略、抗串扰方法与标定思路；
- 作为我们方案的对照组和性能下限/参考线。

最终允许并鼓励：
- 保留原机有效机制；
- 替换原机不够合理或不够现代的实现；
- 在串扰、动态范围、扫描速度、可调增益、标定、可维护性等方面超越原机。

### 对当前文献的重新定位
Johnson et al. 的方案不再只是“判断原机是不是这么做”的证据，而是一个**成熟参考架构**。

后续比较对象调整为：
1. 原40×40系统：实际可工作的参考baseline；
2. Johnson文献架构：公开、机理清晰、串扰量化的参考实现；
3. 当前8×8 v1.0：我们的实验原型；
4. 最终v2方案：基于实验结果选择最合理的架构，而非强制复制其中任意一个。

### 当前监工策略
不立即推翻v1.0，也不立即照抄文献。

先回答四个问题：
1. v1.0为什么在10k/22k有响应、47k/100k失效？
2. 文献“active row = Vin、inactive rows = hard GND、selected column = virtual GND”的架构对真实织物是否明显更稳定？
3. 8列并行TIA与“输出MUX + 单TIA”在串扰、速度和复杂度上的真实差异是什么？
4. 原机实际使用了哪些机制，哪些值得保留，哪些可以改进？

### 下一阶段
项目状态由 `PAUSED_ARCHITECTURE_REVIEW` 调整为：

**ARCHITECTURE_EVALUATION**

下一步不是继续做热图，也不是直接重做PCB，而是制定一个能公平比较不同硬件拓扑的最小实验矩阵。

---

## 32. 监工记录 #014 — ARCH-01A 启动：直接TIA完整传递函数

**时间：2026-08-15 00:01 +08:00**

### 当前目标
停止凭现象猜测，开始建立可追溯数据链。第一步只隔离验证 U1A TIA 本身：

`U1 Pin2 → Rtest → GND`

本Gate完全绕过：
- 真实传感器；
- ROW/COL矩阵；
- 74HC4051扫描路径；
- 热图/阈值/压力算法。

### 核心问题
解释此前异常：
- 10k/22k有高输出；
- 47k/100k掉回VREF；
- FAST-A直接接U1 Pin2时10k又能正常响应。

本Gate必须回答：
1. TIA本身是否对10k~1.5M连续、单调响应？
2. `ΔV` 与 `1/R` 是否符合线性关系？
3. 实际等效反馈增益是否等于物理Rf？
4. 47k/100k异常是在TIA层就存在，还是只在加入ROW/COL路径后出现？

### 当前Gate状态
**ARCH-01A：AUTHORIZED / WAITING_EXECUTION**

### 纪律
Codex必须严格执行独立文件：
`ORDER-ARCH-01A_直接TIA完整传递函数验证.md`

本Gate完成前：
- 不接真实传感器；
- 不修改Rf/Cf/VREF；
- 不修改ADC3 pin map；
- 不做矩阵扫描；
- 不做热图/阈值；
- 不进入v2硬件设计。

---

## 33. 监工记录 #015 — ARCH-01A 进入实体执行

**时间：2026-08-15 03:02 +08:00**

### 当前状态
**ARCH-01A：EXECUTING**

本轮只验证：
`U1 Pin2 -> Rtest -> GND`

严格绕过：
- 真实传感器；
- 74HC4051 ROW路径；
- 矩阵网络；
- 压力算法和热图。

### 用户当前实体操作
1. 断开真实8×8传感器；
2. 4051保持禁用；
3. 保留U1A原反馈 `10kΩ || 100pF`；
4. 标准电阻直接接在 `U1 Pin2` 与 `GND` 之间；
5. 依次执行 OPEN / 1.5M / 470k / 220k / 100k / 68k / 47k / 22k / 10k / 重复关键点 / OPEN；
6. 每次只更换Rtest，不改其他接线。

### 当前禁止
- 不接ROW0；
- 不通过外部COL0端子接Rtest；
- 不接真实传感器；
- 不改Rf/Cf/VREF；
- 不改ADC配置；
- 不用滤波掩盖RAW异常。

---

## 34. 监工记录 #016 — ARCH-01A实体接线确认

**时间：2026-08-15 03:14 +08:00**

### 用户已确认
- `传感器 COL0 -> U1 Pin2` 已拔除；
- 本轮将在 `U1 Pin2 -> Rtest -> GND` 直接换阻；
- 阻值序列：1.5M / 470k / 220k / 100k / 68k / 47k / 22k / 10k；
- 其他硬件保持不变。

### 监工确认
**接线方案正确。**

补充要求：
- 开始前做OPEN_PRE；
- 关键点100k/47k/22k/10k再重复一次；
- 最后做OPEN_POST；
- 4051保持禁用；
- 本Gate只允许改变Rtest。

---

## 35. 监工记录 #017 — ARCH-01A Run01 验收

**时间：2026-08-15 04:20 +08:00**  
**Codex commit：`6a54f2f35f17885a07d9811a75430dfa73f648b2`**

### Gate判定
**ARCH-01A Run01：FAIL**

但当前**不能判定“TIA本身失败”**。

### 关键证据
首轮从高阻到47k实际上表现出连续且接近理论的响应：
- OPEN_PRE = 1.035375 V
- 1.5M = 1.042422 V
- 470k = 1.057354 V
- 220k = 1.085123 V
- 100k = 1.142714 V
- 68k = 1.190520 V
- 47k = 1.264552 V

随后出现状态级跳变：
- 22k = 1.035237 V（近似OPEN）
- 10k = 1.915829 V
- 100k_REPEAT = 1.915604 V（近似仍处于10k状态）
- 47k_REPEAT = 1.915409 V（同上）
- 22k_REPEAT = 1.105073 V
- 10k_REPEAT = 1.034969 V（近似OPEN）
- OPEN_POST = 1.222668 V（明显不是OPEN）

### 监工分析
这种重复序列不符合任何合理的连续TIA非线性模型，更像：
1. 换阻动作与condition标签失同步；
2. 面包板/测试点接触不可靠；
3. 上一颗电阻未完全移除或测试节点残留错误连接；
4. 脚本在用户真正完成换阻之前进入下一condition。

因此下一步先验证**实验状态完整性**，而不是改TIA。

### 当前状态
- ARCH-01A：FAIL / REWORK
- 下一命令：`ORDER-ARCH-01A-R1`
- 真实传感器继续保持断开
- 禁止进入ROW/4051和V2设计

---

## 36. 监工记录 #018 — R1暂停，转入软件采集链一致性审计

**时间：2026-08-15 05:03 +08:00**

### 用户状态
用户已经多次重复换阻/preview操作，继续要求重复同类手工动作的信息增益很低，且造成明显疲劳。

### 监工判定
**ORDER-ARCH-01A-R1：PAUSED_BLOCKED**

不再要求用户继续重复100k/47k/22k/10k换阻。

### 当前最关键的新证据
同一轮中出现：

- 用户万用表：`U1 Pin1 ≈ 1.14 V`
- Codex直接实时串口120帧：`c0 ≈ 1.142236 V`
- 但R1 preview/采集脚本多次看到：`c0 ≈ 1.035 V`

因此当前问题已经不能只归因于实体接触。

更强的新假设是：

> **R1采集脚本/串口缓冲/帧同步/采集时序存在状态不一致，导致脚本读取到旧帧、错误窗口或非当前硬件状态的数据。**

### 当前状态
- TIA是否连续：未完成最终判定
- U1A能响应：已确认
- ADC3 COL0能读到1.142V：已确认
- R1自动采集结果可信度：待审计
- 下一命令：`ORDER-ARCH-01A-R2`

---

## 37. 监工记录 #019 — R2通过，根因范围收敛到测试夹具/换阻状态

**时间：2026-08-15 05:10 +08:00**  
**Codex commit：`bcd9b36`**

### R2判定
**ORDER-ARCH-01A-R2：PASS**

固定硬件状态下：
- raw_terminal = 1.142618 V
- preview = 1.142407 V
- capture = 1.142295 V
- 最大差值 = 0.323 mV
- session一致
- seq连续
- 无双reader争抢串口

因此：
> 软件采集链不是ARCH-01A Run01异常的主要根因。

### 更强的电气证据
ARCH-01A首轮在1.5M→47k区间的数据与理想TIA关系高度一致：

- 1.5M：1.0424 V
- 470k：1.0574 V
- 220k：1.0851 V
- 100k：1.1427 V
- 68k：1.1905 V
- 47k：1.2646 V

结合Rf≈10.17kΩ、VREF≈1.03V，这些点均落在合理理论附近。

因此当前最合理结论：

1. U1A TIA本体在至少47k~1.5M范围内是连续可工作的；
2. ADC3 COL0与软件读取链是可信的；
3. 22k之后出现的OPEN/10k/重复点错乱，不符合连续模拟电路行为；
4. 根因范围收敛到**测试夹具/面包板接触/换阻状态没有真正稳定切换**；
5. 尚未定位具体哪个孔位、跳线或接触点，因此不能声称已经找到唯一物理故障点。

### 项目状态
- 软件采集可信度：PASS
- TIA 47k~1.5M连续性：强证据支持PASS
- 22k/10k低阻区：尚未可靠测完
- 人工重复换阻：停止
- 下一步：建立固定自动电阻选择夹具，一次接好，之后由Codex自动切换。

---

## 38. 监工记录 #020 — 改用U2交叉通道对照，暂停自动电阻MUX夹具

**时间：2026-08-15 05:15 +08:00**

### 用户提出
使用U2另一条独立TIA链路重复关键阻值测试，以快速判断异常是否局限于U1A局部硬件。

### 监工判断
**该思路成立，而且比立即搭第二片4051自动换阻夹具的信息增益更高。**

原因：
- U2A拥有独立MCP6002运放、独立反馈网络、独立COL输入节点和独立ADC3通道；
- 但仍共享3.3V、VREF、ADC3、固件采集框架；
- 因此可有效区分“U1局部问题”与“公共电源/参考/采集方法问题”。

### 注意
U2测试不能单独排除所有线路问题；它能排除的是：
- U1A芯片局部问题；
- U1A反馈网络问题；
- U1 Pin2/Pin1附近局部接触；
- COL0/PF4这一路ADC通道局部问题。

若要进一步排除测试夹具问题，需确保U2测试使用新的固定测试点，并记录OPEN恢复。

### 状态
- 原计划 `ORDER-ARCH-01A-R3 自动电阻选择夹具`：**ON HOLD**
- 新命令：`ORDER-ARCH-01A-R3A U1/U2交叉通道对照`

---

## 39. 监工记录 #021 — U2 100k同样无响应，停止重复插拔

**时间：2026-08-15 05:42 +08:00**

### 新证据
U2A对照：
- OPEN_PRE ≈ 1.03596 V
- 插入100k后多次preview ≈ 1.0356~1.0357 V
- 用户已重新插接并改到面包板，结果仍无变化。

### 监工判断
这说明问题不能再简单归因于“U1A单通道故障”。

但目前也**不能直接判定公共TIA架构有问题**，因为还没有确认100k插入时U2 Pin2节点的真实电压状态。

### 决策
停止继续要求用户重复插拔100k。

保持当前100k不动，进入一次固定状态三节点诊断：
- U2 Pin3
- U2 Pin2
- U2 Pin1

只测这三个电压即可决定下一步故障树。

---

## 40. 监工记录 #022 — U2三节点结果重新判定：TIA本体正常，问题转向Pin1→ADC链路

**时间：2026-08-15 05:45 +08:00**

### 用户澄清
U2固定100k状态下，Pin1~Pin3依次为：
- Pin1 = **1.14 V**
- Pin2 = **1.03 V**
- Pin3 = **1.03 V**

### 监工判定
这组结果恰好符合正常TIA行为：

- Pin3 = VREF ≈ 1.03 V
- Pin2 ≈ Pin3 ≈ 1.03 V（虚参考成立）
- 100k接地时 Pin1 ≈ 1.14 V（输出正确抬升）

因此：

> **U2A模拟TIA本体 PASS。**

但Codex此前对软件COL2读数仍约1.035 V，因此异常范围进一步收缩到：

`U2 Pin1 -> PF6 -> ADC3_INP8 -> ADC Rank/软件COL2映射`

下一步不再动100k，不再换阻，只核验U2输出到ADC链路。

---

## 41. 监工记录 #023 — 模拟TIA层暂判通过，转入输出到ADC链路排查

**时间：2026-08-15 05:49 +08:00**

### 已确认
在 `Pin2 -> 100k -> GND` 条件下，U1A 与 U2A 均出现：
- Pin1 ≈ 1.14 V
- Pin2 ≈ 1.03 V
- Pin3 ≈ 1.03 V

该结果与 `VREF≈1.03V、Rf≈10.17kΩ、Rtest≈100kΩ` 的TIA理论一致。

### 当前结论
**MCP6002模拟TIA本体在100k固定状态下工作正常。**

### 下一层排查优先级
1. U2 Pin1 -> PF6 物理连通性；
2. 上电时 PF6 实际电压是否等于 U2 Pin1；
3. ADC3 Rank3 / ADC3_INP8 / 软件 c2 映射；
4. 全8路RAW中1.14V实际出现在哪一路；
5. 只有输出到ADC链路通过后，才回到换阻/condition稳定性和完整传递函数。

### 当前禁止
- 不再换阻；
- 不接真实传感器；
- 不启用ROW扫描；
- 不修改Rf/Cf/VREF。

---

## 42. 监工记录 #024 — 转入ADC分层诊断：先做PF6单通道Polling

**时间：2026-08-15 06:04 +08:00**

### 当前固定硬件
保持 U2A 的 100k 测试状态不动：
- U2 Pin2 -> 100k -> GND
- U2 Pin1 ≈ 1.14V
- U2 Pin2 ≈ 1.03V
- U2 Pin3 ≈ 1.03V
- U2 Pin1 -> PF6 连通正常
- PF6 物理电压 ≈ 1.14V

### 决策
不拆100k，不再做人工换阻。

ADC排查采用逐层降维：
1. ADC3_INP8/PF6 单通道 + polling + 无DMA
2. 若PASS，再做8通道scan + polling + 无DMA
3. 若PASS，再恢复8通道scan + DMA，定位DMA/cache/时序问题

### 当前Gate
`ADC-01 PF6单通道Polling验证`

---

## 43. 监工记录 #025 — ADC-01 单通道Polling通过

**时间：2026-08-15 06:13 +08:00**  
**Codex commit：`9b305f4d199b7418b1faca06da002d95e429754e`**

### ADC-01判定
**PASS**

固定硬件条件：
- U2 Pin2 -> 100k -> GND
- PF6物理节点约1.14V

单通道ADC3 polling结果：
- Rank1 = Channel 8
- PCSEL_CH8 = 1
- DIFSEL_CH8 = 0
- DMA = 0
- count = 1000
- mean = 1.143310 V
- std_raw = 57.606
- min = 1.137682 V
- max = 1.152994 V
- seq gaps = 0
- rail anomaly = 0

### 结论
以下链路已闭环验证：
`U2 Pin1 -> PF6 -> ADC3_INP8 -> ADC3 DR -> CPU polling`

因此当前问题进一步收敛到：
- 多Rank扫描配置/顺序；
- 或 DMA / buffer / cache /读取时序。

### 下一Gate
`ADC-02：8通道Scan + Polling + 无DMA`

本Gate继续保持100k固定，不需要用户做任何硬件操作。

---

## 44. 监工记录 #026 — ADC-02通过，故障层锁定到DMA路径

**时间：2026-08-15 06:19 +08:00**  
**Codex commit：`0f0735c09ebebbe555b3b130619f4366189f7bd1`**

### ADC-02判定
**PASS**

固定100k、硬件完全不动条件下：
- 8-rank scan + polling + no DMA
- r3 / c2 / PF6 = 1.143634 V
- ADC-01 single polling = 1.143310 V
- 差值仅 +0.324 mV
- SQR顺序正确
- PCSEL正确
- DIFSEL正确
- 1000帧无timeout、无rank anomaly、无seq gap

### 当前结论
以下两层均已验证：
1. `PF6 -> ADC3_INP8 -> 单通道polling`：PASS
2. `8-rank ADC3 scan -> 逐rank polling`：PASS

因此当前异常范围正式收敛到：

`ADC3 scan -> DMA request/transfer -> DMA buffer -> CPU读取/cache/完成时序`

### 下一Gate
`ADC-03A：恢复原始DMA路径，只做故障复现与运行时审计`

本Gate不修改模拟硬件，不要求用户进行任何操作，也不先“修复”DMA。

---

## 45. 监工记录 #027 — ADC-03A 未复现：DMA 链路闭环验证

**时间：2026-08-15 06:27 +08:00**  
**Codex commit：`21e2b09fa34f2a1c6b3ca3d8df2fdad8d551601f`**

### 固定硬件
- U2 Pin2 -> 100k -> GND
- U2 Pin1 / PF6 物理电压约 1.14V
- 100k 不拆不换；真实传感器不接；4051 禁用；Rf/Cf/VREF 不改

### 结果
`ORDER-ADC-03A：NOT_REPRODUCED`

- r3/c2（PF6）DMA 实测 = **1.143236 V**
- ADC-02 polling 参考 = 1.143634 V，差 **−0.398 mV**
- `read_before_tc_count = 0 / 1000`
- `callback_seen_count = 1000 / 1000`
- NDTR after Start_DMA = 8（1000/1000），NDTR at read = 0（1000/1000）
- ADC OVR = 0，DMA error = 0
- PAR after Start = `0x58026040`（ADC3 DR），M0AR = `0x24000086`（buffer）
- D-cache = NO；DMAMUX req = 115；DMNGT = 1（DMA oneshot）

### 监工判定
**ADC-03A：NOT_REPRODUCED（即 DMA 链路 PASS）**

原“软件读 1.035V / 硬件 1.14V”的矛盾，在逐层降维（ADC-01 单通道 polling → ADC-02 8-rank polling → ADC-03A DMA）后全部读回 ~1.14V，未复现任何 DMA / buffer / cache 故障。

结合 R2 软件链审计（三 reader 差 0.323 mV）与 #028 代码审计，可确认：**采集链不是故障源**。

---

## 46. 监工记录 #028 — 代码级审计：采集链逐行等价，故障归因测试夹具

**时间：2026-08-15 08:09 +08:00**  
**证据：`reports/notes/2026-08-15_order-adc-03a_arch-vs-adc03a_code-audit.md`**

### 审计结论
- ARCH-01A（失败）与 ADC-03A（通过）的固件采集链**逐行等价**：
  - `.ioc` 零差异；
  - ADC3 初始化等价（8 rank、DMA oneshot、16-bit、64.5 cycles）；
  - `Read_Adc3_Once()` ≡ ADC-03A 采集函数，均 `HAL_ADC_Start_DMA → wait ConvCpltCallback → read buffer → Stop_DMA`；
  - `stm32h7xx_hal_msp.c` DMA 分支等价（DMA1_Stream1 / DMA_REQUEST_ADC3 / halfword）。
- 两者都禁用 4051、不扫 ROW、不涉及 settle，故“ROW/ADC 启动顺序”等疑点在本直连 TIA 模式下不适用。

### 监工结论
**ARCH-01A 的失败不能由代码差异解释，应归因于物理测试路径/接触/换阻协议的不稳定。**

差异只存在于物理域：ARCH-01A 用 U1A/COL0/PF4 + 14 条件手动换阻；ADC-03A 用 U2A/COL2/PF6 + 固定 100k 零换阻。

### 综合结论（闭环）
至此，整条故障链收敛为单一结论：

> **TIA（U1A/U2A）、ADC3、DMA、buffer、软件采集链全部验证正常；此前反复出现的“47k/100k 掉回 VREF”“软件读 1.035V”均非电气/固件故障，而是面包板测试夹具的接触与换阻状态不稳定。**

---

## 47. 当前执行命令 —— 下一步建议（待确认，暂不下发）

### 建议 ORDER-ARCH-01A-R4：稳定夹具单次干净传递函数

**目标：回答唯一未闭环问题——U1A TIA 在 10k~1.5M 是否连续、单调（H1 原始目标）。**

- 硬件：固定测试点（TEST_A 永久接 U1 Pin2、TEST_B 永久接 GND，接触焊牢/锁紧而非面包板压接）；每点先 OPEN 校验、确认电阻确实在路。
- 固件：复用已验证的 DMA 采集路径，无需改固件。
- 一次扫 10k→1.5M，含 OPEN_PRE/POST 与关键点重复。

### 本 Gate 完成前禁止
- 不接真实传感器；
- 不启用 ROW/4051 扫描；
- 不修改 Rf/Cf/VREF；
- 不进入 v2 硬件设计。
