Dreamdealer1-crypto/forceSensor_8x8/方案/8x8_织物压力矩阵_零电位TIA_开发与验收方案_v1.0.md

# 8×8 织物压力矩阵零电位/TIA验证平台
## 开发、测量、验收与逆向复现执行方案（Codex执行 / ChatGPT监工）

**文档版本：v1.0**  
**日期：2026-08-12**  
**目标平台：NUCLEO-H743ZI2（STM32H743ZIT6）**  
**阶段目标：先在8×8平台上证实/证伪“阻性矩阵 + 零电位硬件解耦 + TIA读出”假设，再回到原40×40设备做同类拓扑比对；禁止仅凭推测直接宣称已复现原机。**

---

# 0. 角色与执行纪律

## 0.1 角色分工

### Codex：具体执行者
负责：
- STM32CubeMX / STM32CubeIDE工程配置；
- STM32H743固件开发；
- GPIO、ADC3、DMA、USART3调试；
- 串口采集程序；
- 实验数据保存、统计和绘图；
- 按本文件要求执行标准电阻实验、串扰实验和真实8×8传感器实验；
- 每个Gate提交完整证据。

### ChatGPT（GPT-5.6 Sol）：监工 / 审查者
负责：
- 审查Codex是否遵守冻结硬件方案；
- 检查代码、ADC通道顺序、扫描时序和数据索引；
- 检查数据是否足以支持结论；
- 对每个Gate给出 `PASS / FAIL / WAITING / 返工`；
- 决定是否允许进入下一阶段；
- 在新证据出现后更新技术判断。

## 0.2 硬约束

未经监工明确批准，Codex **不得擅自修改**：
- 74HC4051控制引脚；
- ADC3的8路引脚分配；
- ROW侧 `100 kΩ → VREF` 拓扑；
- COL侧“每列独立TIA”拓扑；
- 初版TIA `Rf = 10 kΩ`；
- 初版TIA `Cf = 100 pF`；
- VREF分压 `2.2 kΩ / 1 kΩ`；
- MCP6002供电方式；
- 8×8扫描方向和ROW/COL定义。

任何“为了方便”而改引脚、换ADC外设、把COL改接第二片4051、删除TIA、用算法代替硬件解耦等行为，均视为 **违反基线**。

---

# 1. 项目要回答的核心问题

当前不是证明一个既定结论，而是用可证伪实验回答：

1. 原/现有织物压力矩阵的主要可读模拟量是否可以由ROW-COL之间的等效电阻/电导描述？
2. “选中ROW拉低、未选中ROW拉到VREF、所有COL由TIA钳位到VREF”是否能显著降低sneak path / ghosting？
3. 如果该方法有效，效果发生在模拟硬件端还是必须依赖软件补偿？
4. 8×8验证平台是否能获得稳定、可重复、可定位的压力矩阵数据？
5. 原40×40设备是否采用同类电位控制/有源模拟前端？
6. 只有在上述证据闭环后，才能进入40×40复刻设计。

---

# 2. 当前已知证据

## 2.1 原设备证据
已知原系统：
- 为40×40矩阵，80根经纬线独立引出；
- 原主控为STM32F407VET6；
- 上位机存在1600点矩阵处理；
- 对原传感器直接在人为选定的一根经线和一根纬线之间接标准电阻时：
  - **10 kΩ：软件出现一个点；**
  - **100 kΩ：该点消失。**

### 当前解释
该结果强烈说明原系统对ROW-COL之间的**等效电导变化**敏感，但还不能仅凭“10 kΩ有点、100 kΩ没点”判断：
- 真实检测阈值就是10~100 kΩ；
- 原传感器正常工作时单像素电阻一定处于10~100 kΩ；
- 100 kΩ没有物理响应。

原因：原上位机可能存在显示阈值、基线扣除或非线性映射。

因此必须继续做标准电阻扫值并尽量读取原始ADC/串口数据。

---

# 3. 当前冻结硬件方案

## 3.1 主控
- 板卡：NUCLEO-H743ZI2
- MCU：STM32H743ZIT6
- 数字控制：GPIO
- 模拟采集：**ADC3单外设，8通道规则序列**
- PC调试输出：优先使用板载ST-LINK VCP对应的USART3
- 初期串口：115200 8N1

---

# 4. VREF生成

## 4.1 接线
从NUCLEO的3.3 V自行生成约1.03 V的模拟偏置：

- `3V3 → 2.2 kΩ → VREF节点`
- `VREF节点 → 1 kΩ → GND`
- `VREF节点 → 10 µF → GND`
- `VREF节点 → 100 nF → GND`

理论值：

`VREF = 3.3 × 1k / (2.2k + 1k) = 1.03125 V`

## 4.2 注意
- **不要使用主板标记为VREFP的引脚作为本项目VREF。**
- 本项目的VREF是外部分压生成的**模拟偏置节点**。
- 当前4颗MCP6002全部用于8路TIA，因此v1.0不单独使用运放缓冲VREF。
- 2.2k/1k分压电流约1 mA，而被选中的一根ROW经100k向GND额外抽取约10 µA，作为原理验证可接受。
- 固件中的计算必须使用**实测VREF**，不能硬编码1.000 V或1.03125 V作为最终标定值。

## 4.3 VREF上电验收
接传感器前测量：
- 目标：约1.03 V；
- 记录静态电压；
- 记录8行连续扫描时的最大/最小VREF；
- 若扫描时VREF下陷超过10 mV或出现明显周期性波动，STOP，先处理VREF。

---

# 5. 74HC4051：ROW选择网络

## 5.1 冻结接线

| 74HC4051模块 | STM32 / 系统连接 |
|---|---|
| VCC | 3V3 |
| GND | GND |
| VEE | GND |
| Z / COM | GND |
| S0 | PE14 |
| S1 | PE11 |
| S2 | PE9 |
| E / INH | **PG5** |
| Y0 | ROW0 |
| Y1 | ROW1 |
| Y2 | ROW2 |
| Y3 | ROW3 |
| Y4 | ROW4 |
| Y5 | ROW5 |
| Y6 | ROW6 |
| Y7 | ROW7 |

> PG5是当前用户已经完成的真实接线。后续不得恢复成旧方案PG12。

## 5.2 每根ROW的100 kΩ
每一根ROW的同一电气节点同时：
1. 直接接对应的4051 `Yn`；
2. 再通过 **100 kΩ** 接到VREF。

即：
- ROW0 ↔ Y0，同时 ROW0 → 100 kΩ → VREF；
- ROW1 ↔ Y1，同时 ROW1 → 100 kΩ → VREF；
- ...
- ROW7 ↔ Y7，同时 ROW7 → 100 kΩ → VREF。

**100 kΩ不是串联在ROW和4051之间。**

## 5.3 4051工作逻辑
- `E = 1`：全部通道关闭；
- `E = 0`：由S2/S1/S0选择Y0~Y7；
- 由于Z接GND，被选中的ROW被拉向GND；
- 未选中的ROW不经过4051到GND，而由100 kΩ恢复/维持在VREF附近。

S2 S1 S0对应：
- 000 → ROW0
- 001 → ROW1
- 010 → ROW2
- 011 → ROW3
- 100 → ROW4
- 101 → ROW5
- 110 → ROW6
- 111 → ROW7

Codex必须在首次扫描前用万用表/示波器验证实际模块S0/S1/S2标号与通道顺序一致，若模块丝印与芯片真值表相反，**只允许在软件ROW索引映射层修正，不允许重新改线。**

---

# 6. MCP6002：8路COL TIA

## 6.1 芯片数量
共有4颗MCP6002，每颗内部2个独立运放：
- U1：COL0 / COL1
- U2：COL2 / COL3
- U3：COL4 / COL5
- U4：COL6 / COL7

正好8路。

## 6.2 每颗MCP6002公共供电
每一颗都必须：
- Pin 8（VDD）→ 3V3；
- Pin 4（VSS）→ GND；
- Pin 8对应的3V3节点与Pin 4对应的GND节点附近跨接 **100 nF** 去耦；
- 当前100 nF允许通过短外接线连接，但必须尽量靠近芯片，且每颗各有一颗。

建议3.3 V模拟电源总线上额外放置：
- 10 µF → GND。

## 6.3 A路TIA固定接法
对每颗MCP6002的A路：
- Pin 2（VINA−）→ 对应COL；
- Pin 3（VINA+）→ VREF；
- Pin 1（VOUTA）→ STM32 ADC3对应引脚；
- Pin 1 ↔ Pin 2 之间：
  - **10 kΩ反馈电阻**
  - **100 pF反馈电容**
  - 二者并联。

## 6.4 B路TIA固定接法
对每颗MCP6002的B路：
- Pin 6（VINB−）→ 对应COL；
- Pin 5（VINB+）→ VREF；
- Pin 7（VOUTB）→ STM32 ADC3对应引脚；
- Pin 7 ↔ Pin 6 之间：
  - **10 kΩ反馈电阻**
  - **100 pF反馈电容**
  - 二者并联。

## 6.5 初版TIA参数
- `Rf = 10 kΩ`
- `Cf = 100 pF`
- `VREF ≈ 1.03 V`

选择10 kΩ反馈的原因：
- 原设备10 kΩ跨ROW-COL时可以产生显示点；
- 100 kΩ时显示点消失；
- 因此第一轮需要高质量覆盖10~100 kΩ区间；
- 若被测等效R = 10 kΩ，理想TIA输出约：
  `Vout ≈ VREF × (1 + Rf/R) ≈ 2.06 V`
- R = 100 kΩ时：
  `Vout ≈ 1.13 V`
- R = 1 MΩ时只比VREF高约10 mV。

这组参数用于**验证**，不是最终量程参数。

## 6.6 饱和边界
当被测电阻过低时，10 kΩ反馈会使MCP6002输出接近3.3 V上限。
因此：
- 校准主区间：10 kΩ ~ 1 MΩ；
- 4.7 kΩ仅用于观察饱和趋势，不作为线性拟合主数据；
- 任何输出接近3.2~3.3 V时标记 `SATURATED`，不能用于传递函数拟合。

---

# 7. ADC3固定映射

## 7.1 COL → MCP6002 → STM32

| COL | MCP6002输出 | STM32引脚 | ADC3通道 |
|---|---|---|---|
| COL0 | U1 Pin1 | PF4 | ADC3_INP9 |
| COL1 | U1 Pin7 | PF5 | ADC3_INP4 |
| COL2 | U2 Pin1 | PF6 | ADC3_INP8 |
| COL3 | U2 Pin7 | PF7 | ADC3_INP3 |
| COL4 | U3 Pin1 | PF10 | ADC3_INP6 |
| COL5 | U3 Pin7 | PC0 | ADC3_INP10 |
| COL6 | U4 Pin1 | PC1 | ADC3_INP11 |
| COL7 | U4 Pin7 | PC2 | ADC3_INP12 |

### 固件内部通道顺序必须固定为
`COL0, COL1, COL2, COL3, COL4, COL5, COL6, COL7`

即ADC3 Regular Rank 1~8必须严格与上述COL顺序一致。

> Codex必须在CubeMX生成代码前逐项核对ADC3 channel assignment。若CubeMX因板级路由/特定引脚变体提示PC2等模拟输入存在特殊连接，必须停止并提交截图/报错给监工，不得自行换引脚。

---

# 8. 8×8传感器连接

## 8.1 ROW
- 8根经线定义为ROW0~ROW7；
- 接4051 Y0~Y7；
- 每根同时通过100 kΩ到VREF；
- 另一物理末端不必再接电路。

## 8.2 COL
- 8根纬线定义为COL0~COL7；
- **不接第二片4051**；
- 分别直接接8个TIA反相输入；
- COL端始终由对应TIA维持在VREF附近。

## 8.3 当前不使用的器件
以下器件在v1.0主采集链路中禁止接入：
- 第二片74HC4051；
- LM393P；
- FDC2214。

FDC2214仅在后续“容性贡献独立验证”Gate中作为独立仪器使用。

---

# 9. 零电位/TIA假设的电气逻辑

选中ROW i：
- 4051将ROW i接近GND；
- 其余ROW通过100 kΩ保持在VREF附近；
- 所有COL由对应TIA的负反馈维持在VREF附近。

因此理想情况下：

### 目标像素
`ROW_selected ≈ 0 V`  
`COL_j ≈ VREF`

目标像素有电位差并产生电流：
`Iij ≈ VREF / Rij`

TIA将电流变为输出电压：
`Vout ≈ VREF + Rf × Iij`

### 未选中像素
`ROW_unselected ≈ VREF`  
`COL_j ≈ VREF`

两端电压差接近0，sneak current显著降低。

重要：
- 文档禁止使用“串扰严格为0”；
- 实际残余误差仍由4051漏电/导通电阻、MCP6002失调、布线漏电、寄生电容、ROW/COL线阻和VREF偏差决定；
- 本项目的任务就是**测出这些实际误差**。

---

# 10. 上电前硬件验收清单

Codex写代码前，人工完成并拍照/记录：

- [ ] 所有模块共地；
- [ ] 4051 VCC = 3V3；
- [ ] 4051 GND = GND；
- [ ] 4051 VEE = GND；
- [ ] 4051 Z = GND；
- [ ] 4051 S0 = PE14；
- [ ] 4051 S1 = PE11；
- [ ] 4051 S2 = PE9；
- [ ] 4051 E = PG5；
- [ ] Y0~Y7分别接ROW0~ROW7；
- [ ] 每个ROW各有100 kΩ到VREF；
- [ ] VREF为2.2k/1k分压；
- [ ] VREF有10 µF + 100 nF到GND；
- [ ] U1~U4 Pin8均3V3；
- [ ] U1~U4 Pin4均GND；
- [ ] 每颗MCP6002各有100 nF电源去耦；
- [ ] 所有Pin3和Pin5接VREF；
- [ ] 每个A路Pin1-Pin2有10k || 100pF；
- [ ] 每个B路Pin7-Pin6有10k || 100pF；
- [ ] 8个输出按固定表接ADC3；
- [ ] 上电前测3V3与GND不存在低阻短路。

---

# 11. 首次上电：不接传感器

## Gate H0：电源和静态工作点

### 操作
传感器ROW/COL全部不接。

测：
1. 3V3；
2. VREF；
3. 4颗MCP6002 Pin3；
4. 4颗MCP6002 Pin5；
5. 8个TIA输出。

### 预期
- VREF约1.03 V；
- Pin3/Pin5均跟随VREF；
- 没有传感器电流时8个TIA输出应接近VREF；
- 不得出现输出长期贴0 V或3.3 V。

### 记录
`gate_h0.csv`：

`channel,vref_v,vout_v,delta_mv`

### 判定
- 任一TIA输出饱和：FAIL；
- VREF严重漂移：FAIL；
- 8路均处于合理静态点：PASS后才进入H1。

---

# 12. Gate H1：标准电阻单通道传递函数

目的：
先证明“采集平台本身能稳定读标准电阻”，避免把电路问题误判成织物问题。

## 12.1 接法
不接真实传感器。

固定ROW0和COL0，用标准电阻跨接：
`ROW0 ↔ Rtest ↔ COL0`

其余矩阵路径全部断开。

## 12.2 标准阻值
按顺序：
- 10 kΩ
- 22 kΩ
- 47 kΩ
- 68 kΩ
- 100 kΩ
- 220 kΩ
- 470 kΩ
- 1 MΩ

可选：
- 4.7 kΩ（只观察是否进入饱和）

## 12.3 每个阻值采集
- 连续采100帧；
- 保存原始ADC；
- 保存换算电压；
- 计算mean / std / min / max；
- 记录实测VREF。

## 12.4 理论关系
对未饱和区：
`ΔV = Vout - VREF ≈ VREF × Rf / Rtest`

因此：
`ΔV` 对 `1/Rtest` 应近似线性。

## 12.5 验收
强PASS建议：
- 10k~220k范围单调；
- 无随机跳满量程；
- `ΔV vs 1/R` 的R² ≥ 0.995；
- 10k~220k理论/实测偏差整体≤5%为优良；
- 1M因信号仅约10mV，主要用于评价噪声，不作为硬性5%误差门槛。

若失败：
- 禁止上真实传感器；
- 检查VREF、反馈网络、MCP供电、ADC rank、面包板漏电和接地。

---

# 13. Gate H2：4051 ROW扫描验证

目的：证明GPIO和4051选择逻辑无误。

## 13.1 方法
暂不接真实传感器。

对ROW0~ROW7逐行选择，用示波器或万用表测：
- 当前选中ROW电压；
- 一个未选中ROW电压；
- E切换前后波形。

## 13.2 预期
- E=1：无ROW通过4051接GND；
- E=0且选择ROW n：ROW n明显接近0 V；
- 未选中ROW保持接近VREF。

## 13.3 必须生成
`row_scan_scope.md`：
- 8个ROW的选择顺序；
- 实测selected voltage；
- 实测unselected voltage；
- 若有示波器，记录切换建立时间。

任何ROW映射错位：
只允许软件修正`logical_row → S2S1S0`映射，不重新接线。

---

# 14. Gate H3：2×2有限电阻矩阵串扰实验

这是整个零电位假设的**关键证伪实验**。

禁止使用“目标点有电阻、其他点全部开路”作为唯一串扰测试，因为真实矩阵其他像素不是无限大。

## 14.1 用标准电阻构造2×2
使用ROW0、ROW1、COL0、COL1。

### 基线
- R00 = 10 MΩ
- R01 = 10 MΩ
- R10 = 10 MΩ
- R11 = 10 MΩ

若没有10 MΩ，可统一使用1 MΩ，但必须在报告中注明替代值。

### 单点模拟按压
- R00 = 10 kΩ
- R01 = 10 MΩ
- R10 = 10 MΩ
- R11 = 10 MΩ

### 对角双点
- R00 = 10 kΩ
- R01 = 10 MΩ
- R10 = 10 MΩ
- R11 = 10 kΩ

## 14.2 A/B对照
对完全相同的电阻矩阵做两种状态。

### A：零电位模式
未选中ROW保留100 kΩ → VREF。

### B：浮空模式
临时断开**未选中ROW的100 kΩ**，让未选中ROW浮空。

其余接线不变。

## 14.3 指标
目标响应：
`S_target = |value_pressed - baseline|`

最大鬼影：
`S_ghost = max(non_target_pixel_change)`

串扰比：
`Kghost = S_ghost / S_target × 100%`

## 14.4 判定
- 强PASS：零电位模式 `Kghost <= 5%`，且相对浮空模式至少改善5倍；
- 可继续优化：5% < Kghost <= 15%，但相对浮空有明确改善；
- FAIL：Kghost > 15%，或零电位与浮空差异小于2倍。

FAIL时不得直接归因于算法，需要优先检查：
- 未选中ROW是否真的接近VREF；
- COL反相端是否真的被钳位在VREF；
- 4051漏电；
- 面包板表面漏电；
- TIA输出是否饱和；
- VREF是否随扫描移动。

---

# 15. Gate H4：真实8×8传感器

只有H0~H3 PASS后才能接真实8×8铜线/织物结构。

## 15.1 基线
无外力：
- 采500帧；
- 保存64点mean/std；
- 生成8×8 baseline heatmap；
- 记录每个像素初始偏差。

## 15.2 单点
至少选择：
- 中央点；
- 四角之一；
- 边缘点。

每个位置：
- 固定约1 cm²加载面积；
- 使用相同手段/砝码；
- 连续10次加载/卸载；
- 每次保持至少5 s。

输出：
- 目标点响应；
- 8邻域响应；
- 最大ghost；
- SNR；
- 恢复时间；
- 重复性。

## 15.3 多点
至少：
- 同行双点；
- 同列双点；
- 对角双点；
- 四点同时。

重点判断是否出现典型阻性矩阵ghosting。

## 15.4 真实传感器PASS条件
不是预设绝对灵敏度，而是：
- 位置与实际按压一致；
- 单点响应具有稳定方向；
- 重复加载可重复；
- SNR足以稳定区分按压/未按压；
- 多点时不存在不可接受的大面积虚假热点；
- 若存在串扰，可以通过硬件参数优化而非只能靠强行阈值抹除。

---

# 16. 固件开发规范

## 16.1 GPIO
定义固定：
- ROW_S0 = PE14
- ROW_S1 = PE11
- ROW_S2 = PE9
- ROW_EN = PG5

全部Push-Pull Output。

## 16.2 ADC3
必须：
- 单独使用ADC3；
- 8个regular ranks；
- rank顺序严格COL0→COL7；
- DMA采集；
- ADC校准在启动阶段执行；
- 首轮采用较保守采样时间；
- 禁止一开始追求最高采样率。

### 初始建议
- Resolution：优先选择CubeMX对ADC3支持的最高可靠分辨率；Codex必须在提交中写明实际分辨率；
- Sampling time：从64.5 cycles或更保守值起步；
- 连续模式：关闭；
- 外部触发：首版软件触发；
- DMA：Normal模式即可，稳定后再考虑Circular；
- Overrun：保护开启。

## 16.3 每行扫描时序
初版固定流程：

1. `E = 1`，关闭4051；
2. 写S0/S1/S2；
3. 等待5~10 µs；
4. `E = 0`，选择ROW；
5. 等待 `T_SETTLE_US = 500 µs`；
6. 做1次8通道dummy scan并丢弃；
7. 做16次8通道scan；
8. 对每COL计算平均值；
9. 保存该ROW的8个结果；
10. 进入下一ROW。

初版不追求帧率。

## 16.4 建立时间优化
H3/H4跑通后，分别测试：
- 50 µs
- 100 µs
- 200 µs
- 500 µs
- 1000 µs
- 2000 µs

若500→1000→2000 µs结果基本不变，则向下寻找最小稳定值。

最终T_SETTLE必须由数据确定，不能凭RC估算直接定值。

---

# 17. 串口调试输出

NUCLEO-H743ZI2默认可通过板载ST-LINK VCP使用USART3。

初版：
- USART3
- 115200 baud
- 8N1

## 17.1 文本协议
为了调试透明，第一版不做复杂二进制协议。

每帧输出：

`FRAME,<seq>,<timestamp_us>,<vref_mv>`

随后8行：

`R0,c0,c1,c2,c3,c4,c5,c6,c7`
...
`R7,c0,c1,c2,c3,c4,c5,c6,c7`

最后：
`END`

所有c值先输出**原始ADC整数**。

禁止固件第一版直接输出“压力值”，否则会隐藏模拟前端问题。

---

# 18. PC端数据工具（Codex任务）

Codex必须提供最小Python工具：

## 18.1 `capture.py`
功能：
- 打开COM；
- 解析FRAME；
- 保存CSV；
- 检测丢帧；
- 保存原始串口日志。

## 18.2 `analyze_transfer.py`
输入H1数据，输出：
- Rtest；
- mean ADC；
- std ADC；
- mean voltage；
- ΔV；
- 1/R；
- 线性拟合R²；
- 传递函数图。

## 18.3 `analyze_matrix.py`
输出：
- 8×8 heatmap；
- baseline；
- delta matrix；
- S_target；
- S_ghost；
- Kghost；
- 指定像素时间序列。

---

# 19. 原设备的并行逆向实验

8×8开发不能替代原40×40逆向。

必须独立完成原设备标准电阻扫值：

建议：
- 1 kΩ
- 4.7 kΩ
- 10 kΩ
- 22 kΩ
- 47 kΩ
- 68 kΩ
- 100 kΩ
- 220 kΩ
- 470 kΩ
- 1 MΩ

每个阻值记录：
- 软件是否显示点；
- 显示强度；
- 若能抓到原始串口，保存对应像素RAW值；
- 其余像素是否出现鬼影。

目的：
建立原机 `RAW = f(Rtest)`，区分：
- 硬件确实在测等效电导；
- 仅仅软件阈值导致10k有点/100k无点。

---

# 20. FDC2214的使用时机

FDC2214当前不接入主链路。

仅当阻性验证完成后，用于独立回答：
- 同一ROW-COL交叉点随压力是否存在稳定的电容变化；
- 电容变化的SNR相对阻性变化是否足以构成主要测量机制。

FDC无法稳定工作**不能直接证明“传感器就是电阻式”**。

---

# 21. Codex分阶段任务单

## Task C0：创建工程
交付：
- CubeMX `.ioc`
- 工程可编译
- GPIO/ADC3/USART3配置截图或文本说明
- 完整pin map

Gate：监工确认后进入C1。

## Task C1：GPIO/4051测试
交付：
- ROW0~ROW7扫描；
- 串口打印当前row；
- 示波器/万用表记录selected/unselected ROW电压。

Gate：H2。

## Task C2：ADC3八通道
交付：
- 8路ADC3 DMA采样；
- 输入悬空时8路RAW；
- TIA静态输出；
- 通道顺序验证。

Gate：H0。

## Task C3：标准电阻
交付：
- H1完整CSV；
- 拟合图；
- R²；
- 饱和区说明。

Gate：H1。

## Task C4：2×2串扰
交付：
- 浮空模式；
- 零电位模式；
- 单点/对角双点；
- Kghost对比。

Gate：H3。

## Task C5：真实8×8
交付：
- baseline；
- 单点；
- 同行/同列/对角多点；
- heatmap；
- SNR和Kghost。

Gate：H4。

## Task C6：参数优化
只有C5通过后：
- T_SETTLE sweep；
- N_AVG sweep；
- Cf可选变化；
- Rf根据真实有效阻值决定是否调整。

所有硬件参数修改必须先提交监工批准。

---

# 22. Codex每次提交必须包含的格式

每次执行结果必须包含：

## 22.1 Summary
- 做了什么；
- 修改了哪些文件；
- 本轮假设是什么。

## 22.2 Hardware
- 实际接线是否完全符合v1.0；
- 是否发生任何临时断开/替换；
- 实测3V3/VREF。

## 22.3 Firmware
- commit/hash（若有git）；
- ADC3分辨率；
- ADC sampling time；
- DMA设置；
- T_SETTLE；
- N_AVG。

## 22.4 Evidence
- build log；
- flash log；
- 串口原始片段；
- CSV路径；
- 图表路径；
- 示波器/万用表结果。

## 22.5 Result
只允许：
- PASS
- FAIL
- WAITING

Codex不得自行宣布“原理已证实”或“与原机一致”；最终结论由监工根据证据给出。

## 22.6 Next
仅写建议下一步，不得在未审批情况下擅自执行涉及硬件基线变化的下一步。

---

# 23. 监工验收标准

ChatGPT监工每轮检查：

1. **硬件一致性**
   - 引脚有没有偷偷改；
   - ROW/COL有没有接反；
   - VREF/Rf/Cf/Rpull是否一致。

2. **数据可信度**
   - 是否保存RAW；
   - 是否只给处理后热图而没有原始数据；
   - 样本量是否足够；
   - 有没有忽略饱和、丢帧、异常点。

3. **实验可证伪性**
   - 有没有对照组；
   - 串扰实验是否使用有限非目标电阻；
   - 是否把“开路矩阵”错误当成真实矩阵。

4. **结论强度**
   - “能检测”不能等同“能稳定使用”；
   - “零电位更好”必须有Kghost量化；
   - “阻性”必须有标准R替代与真实传感器共同证据；
   - “复现原机”必须有原机波形/电路/RAW协议对照。

---

# 24. 当前硬件冻结清单（v1.0）

| 项目 | 冻结值 |
|---|---|
| MCU | STM32H743ZIT6 / NUCLEO-H743ZI2 |
| ROW MUX | 74HC4051 ×1 |
| ROW S0 | PE14 |
| ROW S1 | PE11 |
| ROW S2 | PE9 |
| ROW E | PG5 |
| 4051 Z | GND |
| ROW pull | 100 kΩ → VREF，每行1颗 |
| VREF上臂 | 2.2 kΩ |
| VREF下臂 | 1 kΩ |
| VREF滤波 | 10 µF + 100 nF |
| VREF目标 | ~1.03 V，实际以万用表值为准 |
| COL读出 | 8路独立TIA |
| TIA运放 | MCP6002 ×4 |
| Rf | 10 kΩ |
| Cf | 100 pF |
| MCP去耦 | 每颗100 nF |
| ADC | ADC3单外设 |
| COL0 | PF4 / ADC3_INP9 |
| COL1 | PF5 / ADC3_INP4 |
| COL2 | PF6 / ADC3_INP8 |
| COL3 | PF7 / ADC3_INP3 |
| COL4 | PF10 / ADC3_INP6 |
| COL5 | PC0 / ADC3_INP10 |
| COL6 | PC1 / ADC3_INP11 |
| COL7 | PC2 / ADC3_INP12 |
| Debug UART | USART3 VCP，115200 8N1 |
| 初始T_SETTLE | 500 µs |
| 初始平均 | 16次8通道scan/ROW + 1次dummy |
| 第二片4051 | 不使用 |
| LM393P | 不使用 |
| FDC2214 | 后续独立验证，不接主链 |

---

# 25. 最终阶段路线

## Phase A：8×8电子学验证
目标：
证明标准电阻可稳定读取 + 量化零电位法串扰。

## Phase B：8×8真实织物
目标：
证明真实材料下可以稳定定位、多点采集且噪声/串扰可控。

## Phase C：原40×40板逆向对照
重点：
- selected ROW电位；
- unselected ROW电位；
- COL模拟节点电位；
- ADC输入波形；
- 标准R替代曲线；
- 固件/协议；
- 模拟IC型号与网表。

## Phase D：40×40复刻
只有Phase A~C证据闭环后才允许启动。
此时决定：
- 40路ROW选择架构；
- 40路TIA是否全并行；
- ADC复用方式；
- VREF驱动能力；
- PCB guard / leakage控制；
- 最终校准方法。

---

# 26. 不能提前宣称的结论

在当前阶段，禁止写：
- “原机一定是TIA”；
- “原机一定采用零电位法”；
- “中间层就是纯压阻材料”；
- “8×8成功后40×40只是简单扩展”；
- “串扰已经在拓扑上完全消失”。

当前正确表述：

> 正在建立一个8×8可控验证平台，用标准电阻、真实织物和A/B串扰实验验证“阻性矩阵 + 零电位硬件解耦 + TIA读出”是否能解释并复现原系统的关键采集行为。若实验不支持，该假设必须被排除或修改。

---

# 27. 官方资料基线

Codex开发前应核对以下官方资料：
1. STMicroelectronics — **UM2407, STM32H7 Nucleo-144 boards (MB1364)**；
2. STMicroelectronics — **STM32H742xI/G / STM32H743xI/G Datasheet, DS12110**；
3. Microchip — **MCP6001/1R/1U/2/4 1 MHz Low-Power Op Amp, DS20001733**；
4. Nexperia — **74HC4051 / 74HCT4051 Datasheet**。

已核对的关键点：
- NUCLEO-H743ZI2默认USART3可连接板载ST-LINK Virtual COM Port；
- PF4、PF5、PF6、PF7、PF10、PC0、PC1、PC2均具有所列ADC3模拟输入功能；
- MCP6002为双运放，8脚封装Pin1/2/3与Pin5/6/7分别构成A/B两路，Pin8为VDD、Pin4为VSS；
- 74HC4051具有S0/S1/S2、8个Yn、公共Z和低有效Enable。

---

# 28. 当前下一步

**下一步不是继续改硬件。**

固定执行：
1. 完成全部接线复核；
2. 不接传感器上电测3V3/VREF/TIA静态输出；
3. 通过H0后交给Codex创建STM32工程；
4. Codex先完成4051 ROW扫描和ADC3八通道RAW采集；
5. 先跑标准电阻H1；
6. 再跑2×2有限电阻矩阵H3；
7. 监工验收PASS后才接真实8×8。

---

# 29. 项目状态台账

| 阶段 | 状态 | 关键证据 | 下一步 |
|---|---|---|---|
| 硬件方案冻结v1.0 | PASS | 4051、4×MCP6002、VREF、ADC3分配已确定 | 接线复核 |
| MCP6002去耦 | PASS/用户已完成 | 每颗100 nF已通过外接线连接 | 测静态工作点 |
| H0 电源/TIA静态 | WAITING | 待测 | 测3V3/VREF/8路Vout |
| C0 STM32工程 | WAITING | 待Codex执行 | H0后开始 |
| H1 标准R传递函数 | WAITING | 待测 | C2完成后 |
| H3 零电位串扰 | WAITING | 待测 | H1 PASS后 |
| H4 真实8×8 | WAITING | 待测 | H3 PASS后 |
| 原40×40对照 | WAITING | 已有10k有点/100k无点初步证据 | 后续标准R扫值 |
| 40×40复刻 | BLOCKED | A~C尚未闭环 | 禁止启动 |

---

**本文件为当前Codex执行基线。后续任何硬件拓扑、固定引脚或关键模拟参数变化，必须由监工审核后升级文档版本。**
