Dreamdealer1-crypto/forceSensor_8x8/方案/8x8_逐模块重建验证状态文档_v1.md

# 8x8 压力矩阵逐模块重建验证状态文档

> 本文档是本轮“完全拆除后从零重接”的独立状态台账。  
> 旧的 `8x8_压力矩阵_监工状态文档_v15.md` 保留为历史故障链记录；本文件只记录新一轮逐模块重建验证。

**当前版本：v1**  
**创建时间：2026-08-17 22:09 +08:00**  
**执行原则：每接一个模块，验证一个模块；未 PASS 不进入下一步。**  
**依据文档：`8x8_逐模块重建验证指南.md`**

---

## 1. 当前总状态

**项目状态：REBUILD_IN_PROGRESS**  
**当前阶段：转入 STEP 16 稳定测试夹具，准备 H1 标准电阻传递函数**  
**当前结论：电源、VREF、4 颗 MCP6002 静态工作点正常；U1A 100kΩ 响应与恢复已通过；8 路 ADC 均在 VREF 附近；4051 禁用态 PASS；ROW 慢速扫描尚未执行。**

### 当前禁止事项

- 禁止接真实 8x8 传感器。
- 禁止在未确认烧录固件模式前接真实传感器或 4051。
- 禁止修改 Rf/Cf/VREF 基线参数。
- 禁止在全 8 路 ADC 基线 PASS 前进入 4051/ROW 扫描。
- 禁止接真实 8x8 传感器。
- 禁止在 STEP 14 ROW 电气验证 PASS 前进入 2x2/真实矩阵实验。

---

## 2. 冻结参数

| 项目 | 当前值 |
|---|---|
| 主板 | NUCLEO-H743ZI2 |
| 模拟电源 | 3V3 |
| VREF | 2.2kΩ / 1kΩ 分压，目标约 1.03V |
| 运放 | MCP6002 |
| U1~U4 A 路反馈 | Pin1 ↔ Pin2：10kΩ ∥ 100pF |
| U1~U4 B 路反馈 | Pin7 ↔ Pin6：10kΩ ∥ 100pF |
| U1~U4 A 同相输入 | Pin3 → VREF |
| U1~U4 B 同相输入 | Pin5 → VREF |
| U1~U4 VDD | Pin8 → 3V3 |
| U1~U4 VSS | Pin4 → GND |

---

## 3. Step 状态表

| Step | 内容 | 状态 | 证据 |
|---|---|---|---|
| STEP 0 | 完全拆除 + 整理元件 | PASS_REPORTED | 用户已进入重建流程并完成前置整理 |
| STEP 1 | 电源总线 | PASS | 3V3 = 3.29V，不发热 |
| STEP 2 | VREF 分压 | PASS | VREF = 1.03V，复测 1.03V，不发热 |
| STEP 3 | U1 仅供电 | PASS | U1 VDD = 3.29V；Pin3/Pin5 位于 VREF 附近 |
| STEP 4 | U1 反馈网络 + 静态输出 | PASS | Pin1/Pin2/Pin6/Pin7 均约 1.02V，无贴轨 |
| STEP 5 | U1A 100kΩ 接地快测 | PASS_WITH_MINOR_GAP | Pin2 → 100kΩ → GND 时 Pin1 = 1.13V；拔掉后 Pin1 = 1.02V；Pin2/Pin7动态补测缺失但静态已正常 |
| STEP 6 | U1 输出接 ADC | READY_OR_PARTIAL | U1 静态和 U1A 快测已通过，等待/确认 PF4/PF5 接入 |
| STEP 7-8 | U2 模块 | STATIC_PASS_REPORTED | 用户报告 U2 未接100k情况下正常 |
| STEP 9-10 | U3 模块 | STATIC_PASS_REPORTED | 用户报告 U3 未接100k情况下正常 |
| STEP 11-12 | U4 模块 | STATIC_PASS_REPORTED | 用户报告 U4 未接100k情况下正常 |
| STEP 13 | 全 8 路 ADC 基线 | PASS_WITH_OBSERVATION | 200帧 A01A RAW；8路均值约 1.036V；c4噪声最大，列为观察 |
| STEP 14 | 4051 模块 | DISABLED_STATE_PASS_WAITING_ROW_SCAN | 4051禁用态：VCC=3.29V，E=3.29V，ROW全约1.02V；接入4051后8路ADC仍约1.035V |
| STEP 15 | 系统完整性验证 | BLOCKED | 等 4051 PASS |
| STEP 16 | 稳定测试夹具 | WAITING_100K_FIXTURE_CHECK | 建立 TEST_A=U1 Pin2、TEST_B=GND；等待 100kΩ 下 U1 Pin1 与串口 c0 验证 |

---

## 4. 监工记录

### 记录 #001 - 新一轮重建开始，STEP 1~4 验收

**时间：2026-08-17 22:09 +08:00**  
**来源：用户万用表实测报告**

#### 用户实测

```text
3V3 = 3.29V
VREF = 1.03V
VREF 复测 = 1.03V
是否发热 = NO

U1 Pin1 = 1.02V
U1 Pin2 = 1.02V
U1 Pin3 = 1.02V
U1 Pin5 = 1.03V
U1 Pin6 = 1.02V
U1 Pin7 = 1.02V
U1 VDD  = 3.29V
```

#### 判定

**STEP 1：PASS**  
3V3 为 3.29V，处于合理范围。

**STEP 2：PASS**  
VREF 为 1.03V，复测仍为 1.03V，且无发热。

**STEP 3：PASS**  
U1 供电正常，VDD=3.29V；Pin3/Pin5 均位于 VREF 附近。

**STEP 4：PASS**  
U1 A/B 两路静态工作点正常。Pin1/Pin2/Pin6/Pin7 均约 1.02V，没有贴近 0V 或 3.3V。

#### 当前技术判断

U1 的供电、VREF 输入、A/B 两路反馈网络和静态虚短状态成立。当前没有证据指向 U1 接反、反馈开路、输出饱和或明显自激。

#### 下一步命令

执行 **STEP 5：U1A 100kΩ 接地快测**。

接线：

```text
U1 Pin2 -> 100kΩ -> GND
```

测量并记录：

```text
U1 Pin1 = ___ V   预期约 1.13V
U1 Pin2 = ___ V   预期约 1.03V
U1 Pin7 = ___ V   预期约 1.02~1.03V
拔掉 100kΩ 后 U1 Pin1 = ___ V   预期恢复到约 1.02~1.03V
```

#### STEP 5 PASS 条件

- 接入 100kΩ 后，U1 Pin1 上升到约 1.13V，允许约 ±30mV。
- U1 Pin2 仍保持约 VREF。
- U1 Pin7 基本不变。
- 拔掉 100kΩ 后，U1 Pin1 恢复到 VREF 附近。

---

## 5. 当前等待用户提交

```text
STEP 6 烧录/ADC准备:
确认 U1 Pin1 -> PF4
确认 U1 Pin7 -> PF5
确认 USB/ST-LINK 已连接
```

---

### 记录 #002 - STEP 5 U1A 100kΩ 接地快测，部分通过

**时间：2026-08-17 22:09 +08:00 后续**  
**来源：用户万用表实测报告**

#### 用户实测

```text
接线：U1 Pin2 -> 100kΩ -> GND
U1 Pin1 = 1.13V
U1 Pin7：用户反馈“不好接电阻”
```

#### 说明

Pin7 不需要接入测试电阻。STEP 5 中测试电阻只接在 U1 Pin2 与 GND 之间；Pin7 是 U1B 输出端，只需要用万用表测量它是否仍保持在 VREF 附近。

#### 判定

**STEP 5：PARTIAL_PASS_WAITING_RECOVERY**

Pin1 在 100kΩ 接地时从静态约 1.02V 上升到 1.13V，符合理论预期：

```text
Vout ≈ VREF × (1 + 10kΩ / 100kΩ) ≈ 1.13V
```

这说明 U1A 的 TIA 主功能已经产生正确响应。完整 PASS 还需要补齐：

```text
U1 Pin2(100kΩ接入) = ___ V   预期约 1.03V
U1 Pin7(100kΩ接入) = ___ V   预期约 1.02~1.03V
U1 Pin1(拔掉100kΩ后) = ___ V 预期恢复到约 1.02~1.03V
```

---

### 记录 #003 - STEP 5 U1A 100kΩ 接地快测闭环

**时间：2026-08-17 22:09 +08:00 后续**  
**来源：用户万用表实测报告**

#### 用户实测

```text
拔掉 100kΩ 后，U1 Pin1 = 1.02V
```

#### 判定

**STEP 5：PASS_WITH_MINOR_GAP**

已确认：

- 接入 `U1 Pin2 -> 100kΩ -> GND` 后，U1 Pin1 = 1.13V，符合理论响应。
- 拔掉 100kΩ 后，U1 Pin1 恢复到 1.02V，说明输出可恢复到静态 VREF 附近。

未补测：

- 100kΩ 接入时 U1 Pin2 的动态电压。
- 100kΩ 接入时 U1 Pin7 的动态电压。

由于 STEP 4 中 U1 Pin2/Pin7 静态均已在 VREF 附近，且 STEP 5 已完成 U1A 响应与恢复闭环，本轮允许进入 STEP 6：U1 输出接入 STM32 ADC 验证。

---

## 6. STM32 烧录准备记录

### 已发现本地工具与工程

```text
烧录脚本：tools/flash-stm32.ps1
工具配置：tools/stm32-tools.local.ps1
STM32_Programmer_CLI = D:\STM32CubeCLT_1.22.0\STM32CubeProgrammer\bin\STM32_Programmer_CLI.exe
arm-none-eabi-gcc    = D:\STM32CubeCLT_1.22.0\GNU-tools-for-STM32\bin\arm-none-eabi-gcc.exe
cmake                = D:\STM32CubeCLT_1.22.0\CMake\bin\cmake.exe
ninja                = D:\STM32CubeCLT_1.22.0\Ninja\bin\ninja.exe
```

### 已发现固件产物

```text
build/firmware/resist_matrix_minimal.hex
build/firmware/resist_matrix_minimal.elf
build/firmware/resist_matrix_minimal.bin
```

### 推荐烧录流程

优先执行工具检查：

```powershell
.\tools\check-stm32-tools.ps1
```

如需重新构建：

```powershell
cmake -S .\firmware -B .\build\firmware -G Ninja -DCMAKE_BUILD_TYPE=Debug
cmake --build .\build\firmware
```

烧录：

```powershell
.\tools\flash-stm32.ps1 -Firmware .\build\firmware\resist_matrix_minimal.hex
```

### 烧录前硬件要求

- 真实 8x8 传感器保持断开。
- 4051 暂不接入。
- 当前最多只允许进入 STEP 6：U1 Pin1/Pin7 接入 PF4/PF5 后做 ADC/串口验证。
- 烧录前确认当前固件模式，避免烧录 ROW 扫描或不适合当前硬件阶段的实验模式。

### 工具检查结果

**时间：2026-08-17 22:09 +08:00 后续**  
**命令：**

```powershell
powershell -ExecutionPolicy Bypass -File .\tools\check-stm32-tools.ps1
```

**结果：PASS**

```text
STM32_Programmer_CLI FOUND  D:\STM32CubeCLT_1.22.0\STM32CubeProgrammer\bin\STM32_Programmer_CLI.exe
arm-none-eabi-gcc    FOUND  D:\STM32CubeCLT_1.22.0\GNU-tools-for-STM32\bin\arm-none-eabi-gcc.exe
cmake                FOUND  D:\STM32CubeCLT_1.22.0\CMake\bin\cmake.exe
ninja                FOUND  D:\STM32CubeCLT_1.22.0\Ninja\bin\ninja.exe
make                 FOUND  D:\STM32CubeCLT_1.22.0\Make\bin\make.exe
STM32CubeProgrammer version: 2.23.0
```

备注：直接执行 `.\tools\check-stm32-tools.ps1` 会被当前 PowerShell Execution Policy 拦截；使用 `powershell -ExecutionPolicy Bypass -File ...` 可在当前命令中临时绕过，不修改系统策略。

---

### 记录 #004 - U1~U4 空载静态工作点用户报告正常

**时间：2026-08-17 22:09 +08:00 后续**  
**来源：用户万用表实测报告**

#### 用户报告

```text
U1-U4 都测过了，都正常的（没接100K情况下）
```

#### 判定

**U1~U4 静态工作点：PASS_REPORTED**

该结果说明 4 颗 MCP6002 在未接测试电阻、未接传感器条件下，供电、VREF、反馈静态输出未出现明显异常。结合前序 U1 详细数据，可进入全 8 路输出接入 STM32 ADC 的准备阶段。

#### 证据边界

本记录只证明 U1~U4 **空载静态工作点正常**。目前只有 U1A 完成了 `100kΩ -> GND` 的功能快测；U2/U3/U4 尚未做逐路 100kΩ 功能快测。考虑当前目标是先建立全 8 路 ADC 基线，允许暂不逐路重复 100kΩ 快测，但后续若某路 ADC 基线异常，应优先回到对应 MCP6002 单路排查。

#### 下一步命令

进入 STEP 13 前置准备：确认 8 路 MCP6002 输出已按固定映射接到 STM32。

```text
U1 Pin1 -> PF4   COL0
U1 Pin7 -> PF5   COL1
U2 Pin1 -> PF6   COL2
U2 Pin7 -> PF7   COL3
U3 Pin1 -> PF10  COL4
U3 Pin7 -> PC0   COL5
U4 Pin1 -> PC1   COL6
U4 Pin7 -> PC2   COL7
```

然后烧录/运行 8 通道 ADC 基线固件，观察串口 RAW 数据是否全在 VREF 附近。

---

### 记录 #005 - STEP 13 烧录与全 8 路 ADC 基线 Run01

**时间：2026-08-17 23:14 +08:00**  
**硬件状态：U1~U4 输出已接入 STM32 ADC；真实传感器未接；4051 未接。**

#### 固件模式确认

源码 `firmware/Core/Inc/main.h` 当前关键宏：

```text
ARCH_01A_DIRECT_TIA_MODE = 0
ADC3_PF6_SINGLE_POLLING_MODE = 0
ADC3_8RANK_SCAN_POLLING_MODE = 0
ADC3_8RANK_DMA_BASELINE_AUDIT_MODE = 1
ORDER_002A_ROW_TEST_MODE = 0
ORDER_003A_FAST_DEBUG_ROW0_MODE = 0
```

实际串口输出为 `A01A` 格式，说明烧录产物来自此前 ARCH_01A 8 路直读固件。该模式保持 4051 禁用、无 ROW 扫描，仍适合当前 STEP 13 空载 8 路 ADC 基线观察。

#### 构建情况

尝试重新构建：

```powershell
cmake --build .\build\firmware
ninja -C .\build\firmware
```

两次均超时且无有效输出，遗留 `.ninja_lock` 已清理。未在本轮重建固件；改用已有产物：

```text
build/firmware/resist_matrix_minimal.hex
```

#### 烧录结果

命令：

```powershell
powershell -ExecutionPolicy Bypass -File .\tools\flash-stm32.ps1 -Firmware .\build\firmware\resist_matrix_minimal.hex
```

结果：**PASS**

关键输出：

```text
ST-LINK SN  : 0024004C3438511034313939
Board       : NUCLEO-H743ZI
Voltage     : 3.28V
Device ID   : 0x450
File        : resist_matrix_minimal.hex
Size        : 30.44 KB
Download verified successfully
MCU Reset
```

#### 串口确认

串口：`COM7`，`115200 8N1`

输出格式：

```text
A01A,<session>,<seq>,<timestamp_us>,c0,c1,c2,c3,c4,c5,c6,c7
```

#### 数据文件

```text
data/rebuild_step13/20260817_run01/a01a_raw.log
data/rebuild_step13/20260817_run01/a01a_samples.csv
data/rebuild_step13/20260817_run01/summary.csv
```

#### 200 帧统计

按 VDDA = 3.29V 估算：

| 通道 | count | mean_raw | std_raw | min_raw | max_raw | mean_mV |
|---|---:|---:|---:|---:|---:|---:|
| c0 | 200 | 20630.830 | 83.179 | 20461 | 20759 | 1035.71 |
| c1 | 200 | 20629.195 | 105.055 | 20444 | 20863 | 1035.63 |
| c2 | 200 | 20638.580 | 69.618 | 20468 | 20855 | 1036.10 |
| c3 | 200 | 20665.795 | 92.066 | 20447 | 20823 | 1037.47 |
| c4 | 200 | 20638.650 | 209.999 | 20258 | 20951 | 1036.11 |
| c5 | 200 | 20667.005 | 124.559 | 20441 | 20927 | 1037.53 |
| c6 | 200 | 20653.260 | 72.083 | 20502 | 20775 | 1036.84 |
| c7 | 200 | 20630.805 | 65.919 | 20517 | 20754 | 1035.71 |

#### 判定

**STEP 13：PASS_WITH_OBSERVATION**

通过依据：

- 8 路均值均在约 1.036V，处于 VREF 附近。
- 无任何一路贴近 0V 或 3.3V。
- 串口 8 路 RAW 连续输出正常。
- ADC 通道顺序以当前固件固定输出 `c0~c7` 记录，后续若接标准电阻需再做单通道定位验证。

观察项：

- c4 的 `std_raw = 209.999`，约等于 10.5mV RMS，高于其余通道。
- c5 的噪声也略高于多数通道。
- 当前不判 FAIL；后续若 c4/c5 在标准电阻或真实矩阵实验中异常，应优先检查 U3、PF10/PC0 跳线、U3 去耦与面包板接触。

#### 下一步建议

进入 4051 前置前，建议任选 2~3 路用万用表交叉测量 MCP6002 输出脚与 ADC 均值是否一致，尤其优先测：

```text
U3 Pin1 / PF10 / c4
U3 Pin7 / PC0  / c5
```

若万用表也稳定在约 1.03V，且无明显跳动，可进入 STEP 14：4051 模块。

---

### 记录 #006 - STEP 14 4051 与 ROW 上拉接线完成

**时间：2026-08-17 23:xx +08:00**  
**来源：用户硬件接线报告**

#### 用户报告

```text
74HC4051 接好
ROW 上拉 100K 电阻接好
VREF 1.03V 接好了
```

#### 判定

**STEP 14：WAITING_MEASUREMENT**

接线阶段完成，但尚未完成电气验收。当前只允许做 4051 禁用/启用状态下的 ROW 电压验证，不接真实传感器。

#### 下一步测量命令

先确认当前固件模式：当前烧录产物输出 `A01A`，该模式应保持 4051 禁用、无 ROW 扫描。若不重新烧 ROW 测试固件，则先做禁用态验证：

```text
4051 VCC 对 GND = ___ V        预期约 3.3V
4051 Z/COM 对 GND = ___ V      预期 0V
4051 VEE 对 GND = ___ V        预期 0V
4051 E/INH(PG5) 对 GND = ___ V 预期高电平/禁用态

ROW0 = ___ V
ROW1 = ___ V
ROW2 = ___ V
ROW3 = ___ V
ROW4 = ___ V
ROW5 = ___ V
ROW6 = ___ V
ROW7 = ___ V
```

禁用态 PASS 条件：

- 4051 供电正常。
- 8 个 ROW 节点都应约等于 VREF，即约 1.03V。
- 任一 ROW 接近 0V，说明可能被 4051 拉低、100k 上拉接错、短路或固件并非禁用态。

禁用态通过后，再烧录/启用 ROW 慢速测试固件，验证 selected ROW≈0V、unselected ROW≈VREF。

---

### 记录 #007 - STEP 14 4051 禁用态与接入后 ADC 基线

**时间：2026-08-17 23:xx +08:00**  
**硬件状态：74HC4051 已接入；8 路 ROW 均已通过 100kΩ 上拉到 VREF；真实传感器未接。**

#### 用户万用表实测

```text
任意/每个 ROW 节点对 GND ≈ 1.02V

4051 VCC 对 GND = 3.29V
4051 Z/COM 对 GND = 0V
4051 VEE 对 GND = 0V
4051 E/INH(PG5) 对 GND = 3.29V
```

#### 禁用态判定

**4051 禁用态：PASS**

通过依据：

- 4051 供电正常。
- Z/COM 与 VEE 均为 0V，符合当前拓扑。
- E/INH 为 3.29V，处于禁用态。
- 8 个 ROW 节点均约 1.02V，说明 100kΩ 上拉到 VREF 生效，且无 ROW 被异常拉低。

#### 接入 4051 后 ADC 复测

串口：`COM7`，`115200 8N1`  
采样：A01A RAW 200 帧  
数据文件：

```text
data/rebuild_step14/20260817_run01_disabled_4051_adc/a01a_raw.log
data/rebuild_step14/20260817_run01_disabled_4051_adc/a01a_samples.csv
data/rebuild_step14/20260817_run01_disabled_4051_adc/summary.csv
```

按 VDDA = 3.29V 估算：

| 通道 | count | mean_raw | std_raw | min_raw | max_raw | mean_mV |
|---|---:|---:|---:|---:|---:|---:|
| c0 | 200 | 20613.250 | 71.169 | 20450 | 20766 | 1034.83 |
| c1 | 200 | 20628.690 | 87.090 | 20406 | 20873 | 1035.61 |
| c2 | 200 | 20631.355 | 57.119 | 20535 | 20751 | 1035.74 |
| c3 | 200 | 20651.625 | 78.326 | 20480 | 20809 | 1036.76 |
| c4 | 200 | 20610.625 | 194.335 | 20308 | 20921 | 1034.70 |
| c5 | 200 | 20635.290 | 106.619 | 20378 | 20837 | 1035.94 |
| c6 | 200 | 20650.945 | 67.051 | 20534 | 20773 | 1036.72 |
| c7 | 200 | 20632.825 | 72.056 | 20420 | 20851 | 1035.81 |

#### ADC 判定

**接入 4051/ROW 上拉后的 8 路 ADC 基线：PASS_WITH_OBSERVATION**

通过依据：

- 8 路均值仍在约 1.035V，和 STEP 13 未接 4051 时一致。
- 无任何一路贴近 0V 或 3.3V。
- 说明 4051 禁用态与 ROW 上拉接入后，未明显扰动 8 路 TIA 输出。

观察项：

- c4 噪声仍为全通道最大，`std_raw = 194.335`，约 9.8mV RMS。
- c5 噪声次高，继续观察 U3 / PF10 / PC0 / 去耦 / 跳线接触。

#### 下一步命令

进入 **STEP 14B：ROW 慢速扫描验证**。需要烧录或启用 ROW 测试固件，验证：

```text
selected ROW ≈ 0V
unselected ROW ≈ VREF ≈ 1.02~1.03V
```

推荐至少记录：

```text
ROW0 selected: ROW0=___V, ROW1=___V
ROW1 selected: ROW1=___V, ROW0=___V
ROW7 selected: ROW7=___V, ROW0=___V
```

---

### 记录 #008 - 转入 STEP 16 稳定测试夹具，准备 H1 传递函数

**时间：2026-08-17 23:xx +08:00**  
**来源：用户指令**

#### 决策

当前暂不继续执行 STEP 14B ROW 慢速扫描，先进入 STEP 16 建立稳定测试夹具，用标准电阻验证 U1A / c0 的完整传递函数。

#### 证据边界

- STEP 14 4051 禁用态已 PASS。
- STEP 14B selected/unselected ROW 慢速扫描尚未执行。
- STEP 15 系统完整性验证尚未执行。
- 当前 H1 夹具测试只验证 `U1 Pin2 -> Rtest -> GND`，不经过真实传感器，不经过 ROW/COL 矩阵。

#### 夹具接线命令

```text
TEST_A：从 U1 Pin2 引出一根固定线
TEST_B：从 GND 引出一根固定线
```

要求：

- TEST_A / TEST_B 接好后不再移动。
- 后续所有标准测试电阻只插在 TEST_A 和 TEST_B 之间。
- 不触碰主面包板上 U1、反馈电阻、反馈电容、VREF、ADC 跳线。
- 真实 8x8 传感器仍保持断开。

#### 100kΩ 夹具预验证

在 TEST_A 与 TEST_B 之间插入 100kΩ 后，提交：

```text
万用表：U1 Pin1 = ___ V      预期约 1.13V
串口：c0 = ___ raw / ___ mV  预期约 1130mV
```

#### 判定条件

**STEP 16 夹具 100kΩ 预验证 PASS** 需要同时满足：

- 万用表 U1 Pin1 约 1.13V。
- 串口 c0 约 1.13V，且明显高于其余空载通道约 1.03V。
- 其余通道 c1~c7 不应被 100kΩ 测试明显拉动。

若万用表为 1.13V 但串口 c0 仍约 1.03V，则优先检查：

- U1 Pin1 -> PF4 跳线；
- 固件输出列索引是否 c0 对应 PF4；
- 串口读取是否来自当前会话。

---

### 记录 #009 - REBUILD-H1 实测电阻/Rf 基准登记与脚本准备

**时间：2026-08-18 +08:00**  
**来源：用户万用表实测报告 + Codex 文档/脚本更新**

#### 标准测试电阻实测值

| 标签 | 实测值 |
|---|---:|
| 10k | 10.12kΩ |
| 22k | 22.3kΩ |
| 47k | 45.9kΩ |
| 68k | 67.88kΩ |
| 100k | 98.28kΩ |
| 220k | 219.2kΩ |
| 470k | 475kΩ |
| 680k | 704.5kΩ |
| 1M | 1.46MΩ |

#### Rf 实测值

| 芯片 | A 路 Pin1-2 | B 路 Pin7-6 |
|---|---:|---:|
| U1 | 9.97kΩ | 10.15kΩ |
| U2 | 10.09kΩ | 9.71kΩ |
| U3 | 10.00kΩ | 10.02kΩ |
| U4 | 9.97kΩ | 10.02kΩ |

H1 目标通道为 U1A / c0，因此理论计算使用：

```text
Rf_target = 9.97kΩ
VREF = 1.03V
```

#### 已更新文件

```text
方案/ORDER-REBUILD-H1_重建后传递函数验证.md
tools/capture_rebuild_h1.py
tools/analyze_rebuild_h1.py
```

#### 脚本检查

```text
python tools/capture_rebuild_h1.py --help   PASS
python tools/analyze_rebuild_h1.py --help   PASS
```

#### 下一步

运行采集脚本，按提示只在 TEST_A / TEST_B 之间换阻：

```powershell
python tools/capture_rebuild_h1.py --port COM7 --samples 1000 --run run01
```

采集完成后分析：

```powershell
python tools/analyze_rebuild_h1.py data/rebuild_h1/<timestamp>_run01
```

---

### 记录 #010 - REBUILD-H1 Run01 中断后直接分析交付

**时间：2026-08-18 +08:00**  
**用户指令：repeat 条件不再补测，直接分析并准备交付数据。**

#### 数据集

```text
data/rebuild_h1/20260818_001616_run01
```

已采条件：

```text
OPEN_BASELINE_PRE
1M
680k
470k
220k
100k
68k
47k
22k
10k
100k_REPEAT
```

缺失条件：

```text
47k_REPEAT
22k_REPEAT
10k_REPEAT
OPEN_BASELINE_POST
```

#### 原始 ORDER 目标通道 c0 分析

命令：

```powershell
python tools/analyze_rebuild_h1.py data/rebuild_h1/20260818_001616_run01
```

结果：**FAIL**

关键结果：

```text
c0 R2 = 0.319638
c0 Rf_eff = 1.651 ohm
Fail reasons:
- COL0 mean Vout is not strictly increasing as R decreases.
- 47k dropped near VREF.
- 100k dropped near VREF.
- R2 < 0.995.
```

#### 关键复核发现

虽然 `c0` 基本保持在 VREF 附近，但 `c1` 随 Rtest 明显变化：

| 条件 | c1 mean |
|---|---:|
| OPEN_BASELINE_PRE | 1035.48 mV |
| 1M | 1042.63 mV |
| 680k | 1035.70 mV |
| 470k | 1057.29 mV |
| 220k | 1082.65 mV |
| 100k | 1140.70 mV |
| 68k | 1187.89 mV |
| 47k | 1260.25 mV |
| 22k | 1498.95 mV |
| 10k | 1913.45 mV |
| 100k_REPEAT | 1140.92 mV |

c1 拟合摘要：

```text
R2 including all primary points = 0.994024228
Rf_eff = 8766.819 ohm
Assumed U1B Rf = 10150 ohm
100k repeat diff = 0.224 mV
```

#### 当前判定

**REBUILD-H1 Run01：FAIL / PARTIAL DATA DELIVERED**

原因：

- 原订单目标为 `c0 / U1A / Pin1-Pin2`，但实际响应出现在 `c1`。
- `680k` 点在 c1 上掉回基线，属于异常点。
- repeat 条件未完整采集，缺少正式重复性闭环。
- OPEN_POST 未采集，缺少基线后验。

#### 技术判断

本轮数据强烈说明有一条 TIA 链路对标准电阻有真实响应，但响应链路更像：

```text
TEST_A -> U1B Pin6 -> U1 Pin7 -> PF5 -> c1
```

而不是原计划的：

```text
TEST_A -> U1A Pin2 -> U1 Pin1 -> PF4 -> c0
```

优先排查：

- TEST_A 是否实际接到了 U1 Pin6，而非 U1 Pin2。
- U1 Pin1/PF4 与 U1 Pin7/PF5 是否跳线或标签对调。
- 固件输出 c0/c1 与物理 PF4/PF5 的映射是否和接线一致。

#### 交付文件

```text
data/rebuild_h1/20260818_001616_run01/analysis_summary.csv
data/rebuild_h1/20260818_001616_run01/control_channels_summary.csv
data/rebuild_h1/20260818_001616_run01/fit_results.json
data/rebuild_h1/20260818_001616_run01/rebuild_h1_c1_target_summary.csv
data/rebuild_h1/20260818_001616_run01/rebuild_h1_c1_fit_summary.json
data/rebuild_h1/20260818_001616_run01/REBUILD_H1_RUN01_PARTIAL_REPORT.md
data/rebuild_h1/20260818_001616_run01/plots/
```

---

### 记录 #012 - REBUILD-H1 Run01 PPT 科研绘图交付

**时间：2026-08-18 +08:00**  
**用户需求：参考 `Scaling Fabric-Based Piezoresistive Sensor Arrays.pdf` 的科研图风格，为汇报/PPT 生成图。**

#### 风格参考

已将参考论文复制并渲染到工作区：

```text
reports/figures/rebuild_h1/reference_pdf/scaling_fabric_arrays.pdf
reports/figures/rebuild_h1/reference_pdf_pages/
```

绘图风格采用：

- 白底；
- 细坐标轴与浅灰网格；
- serif 字体；
- 小面板标签 a-f；
- 克制配色，主响应为蓝色，异常点为红色空心圈；
- 同时输出 PNG 与 PDF，便于 PPT 和论文式排版复用。

#### 输出目录

```text
reports/figures/rebuild_h1/ppt_run01/
```

#### 生成图件

```text
00_ppt_summary_16x9.png/pdf
01_vout_vs_r_log_ieee.png/pdf
02_delta_v_vs_conductance_fit.png/pdf
03_c0_c1_mapping_diagnostic.png/pdf
04_100k_repeatability.png/pdf
05_c1_stitched_time_trace.png/pdf
06_control_channel_drift_heatmap.png/pdf
ppt_plot_summary.csv
README.md
```

#### 图件解释边界

这些图使用 `c1` 作为响应通道，因为本轮采集时已确认 U1 Pin1 / Pin7 到 PF4 / PF5 输出线接反，U1A 响应记录在 `c1`。图中已显式标注：

```text
U1A response was recorded on c1 because PF4/PF5 output leads were swapped during capture.
```

不将本图解释为 `c0` 的传递函数 PASS；它用于展示重建后 TIA 标准电阻响应、通道映射诊断、100k 重复性和控制通道稳定性。

---

### 记录 #011 - 用户确认 TEST_A/TEST_B 位于 U1 Pin2 / Pin4 侧

**时间：2026-08-18 +08:00**  
**来源：用户硬件确认**

#### 用户确认

```text
U1 pin2 pin4 左侧第2、第4个引脚，我确认
```

#### 判定更新

若 U1 的缺口/圆点方向与 DIP-8 标准一致，则左侧第 2 脚为 `Pin2`，左侧第 4 脚为 `Pin4/VSS/GND`。这说明 TEST_A/TEST_B 很可能确实接在：

```text
TEST_A -> U1 Pin2
TEST_B -> U1 Pin4/GND
```

因此，REBUILD-H1 Run01 中 “响应出现在 c1 而非 c0” 的优先怀疑对象从 TEST_A 接错，转移到：

```text
U1 Pin1 / Pin7 输出线是否接反
PF4 / PF5 是否接反
固件 c0/c1 与实际 PF4/PF5 映射是否需要复核
```

#### 下一步诊断命令

在 TEST_A / TEST_B 之间接入 100kΩ，不运行完整扫值，只做四点万用表与串口对照：

```text
U1 Pin1 = ___ V
U1 Pin7 = ___ V
PF4      = ___ V
PF5      = ___ V
串口 c0 = ___ mV
串口 c1 = ___ mV
```

判定：

- 若 `U1 Pin1≈1.13V`、`U1 Pin7≈1.03V`，但串口 `c1≈1.13V`，则高度怀疑 Pin1 输出线接到了 PF5，或 PF4/PF5 标签/跳线对调。
- 若 `U1 Pin7≈1.13V`，则实际响应在 U1B，需重新检查 TEST_A 或反馈/输入节点。
- 若 `PF4≈1.13V` 但 `c0≈1.03V`，则复核固件 ADC rank / c0 映射。

---

### 记录 #012 - H2 ROW扫描快速复验完成

**时间：2026-08-18 01:20 +08:00**  
**命令来源：用户要求直接烧录、完成 H2、分析数据并输出 SVG 图**  
**状态：PASS**

#### 固件动作

已将 `firmware/Core/Inc/main.h` 中的基线审计模式关闭，使固件回到 8 行 ROW 扫描主循环：

```text
ADC3_8RANK_DMA_BASELINE_AUDIT_MODE = 0
```

重新编译并烧录：

```text
build/firmware/resist_matrix_minimal.hex
```

ST-LINK 烧录与 verify 均成功，板端电压报告为 `3.28V`。

#### 数据目录

```text
data/rebuild_h2h3/20260818_012046_run01/
```

#### H2采集结果

```text
采集帧：2轮完整 ROW0~ROW7
行记录：16
点数：128
判据窗口：1020~1060mV
最小值：1025.781mV
最大值：1038.482mV
均值：1032.635mV
两轮最大绝对差：6.426mV
异常点：0
```

#### 判定

```text
ORDER-REBUILD-H2 RESULT
STATUS: PASS
```

结论：在未接真实传感器、未接 ROW-COL 测试电阻的条件下，4051 受固件控制扫描 ROW0~ROW7 时，8 路 ADC 均保持在 VREF 附近；未观察到大于判据窗口的寄生路径或 ROW 切换异常。

#### SVG图件

```text
data/rebuild_h2h3/20260818_012046_run01/figures/h2_ppt_summary_16x9.svg
data/rebuild_h2h3/20260818_012046_run01/figures/h2_row_scan_heatmap.svg
data/rebuild_h2h3/20260818_012046_run01/figures/h2_column_traces.svg
data/rebuild_h2h3/20260818_012046_run01/figures/h2_uniformity_repeatability.svg
```

#### 下一步

H2 已完成，可进入 H3 前的人工夹具准备。不得自行进入 H4。

---

### 记录 #013 - H3实验A初测：目标点未命中，出现映射异常

**时间：2026-08-18 01:35 +08:00**  
**状态：CHECK / 待复核接线映射**

#### 用户指令

```text
接好了直接开测
```

按当前 H3 文档假定为实验A：

```text
ROW2节点 -> 47kΩ -> COL5 / U3 Pin6
其他三个位置不接
```

#### 数据目录

```text
data/rebuild_h2h3/20260818_013500_run02/
```

#### 采集结果

```text
采集帧：100帧完整 ROW0~ROW7
行记录：800
VREF估计：1032.502mV
```

局部点：

```text
ROW2-c5 = 1031.827mV
ROW2-c6 = 1031.852mV
ROW3-c5 = 1215.605mV
ROW3-c6 = 1031.243mV
```

全矩阵高点：

```text
ROW2-c4 = 1226.863mV
ROW3-c5 = 1215.605mV
```

#### 判定

```text
H3 Experiment A STATUS: CHECK
```

预期目标 `ROW2-c5` 未响应；实际出现两个高点 `ROW2-c4` 与 `ROW3-c5`。该结果不能作为 H3-A PASS，也暂不进入 H3-B/C 判定。

#### 优先复核

```text
1. 是否实际只接了一颗 47kΩ
2. ROW2 / ROW3 节点是否拿错或相邻短接
3. COL5 是否实际落到 ADC c4，存在列编号偏移
4. U3 Pin6 附近是否碰到相邻列或相邻 TIA 输入
```

#### SVG图件

```text
data/rebuild_h2h3/20260818_013500_run02/figures/h3_heatmap_exp_a.svg
data/rebuild_h2h3/20260818_013500_run02/figures/h3_local_response_bar.svg
```

---

### 记录 #014 - H3实验A正式通过：ROW2-COL4 单像素

**时间：2026-08-18 01:47 +08:00**  
**状态：PASS**

#### 接线

```text
ROW2节点 -> 47kΩ -> U3 Pin2 / COL4 / c4
其余 2×2 位置不接
```

#### 数据目录

```text
data/rebuild_h2h3/20260818_014709_expA_run01/
```

#### 结果

```text
VREF估计：1032.146mV
ROW2-c4：1252.320mV
ROW2-c5：1032.168mV
ROW3-c4：1030.862mV
ROW3-c5：1030.866mV
目标Delta：220.174mV
最大局部Ghost Delta：1.283mV
Kghost_local：0.583%
```

#### 判定

目标信号只出现在 `ROW2-COL4 / c4`，局部 ghost 远低于 5% 判据。H3 实验A通过。

#### SVG图件

```text
data/rebuild_h2h3/20260818_014709_expA_run01/figures/h3_heatmap_exp_a.svg
data/rebuild_h2h3/20260818_014709_expA_run01/figures/h3_local_response_bar.svg
```

#### 下一步

保持实验A电阻不变，进入实验B：增加 `ROW3节点 -> 47kΩ -> U3 Pin6 / COL5 / c5`。

---

### 记录 #015 - H3实验B正式通过：双对角目标

**时间：2026-08-18 01:50 +08:00**  
**状态：PASS**

#### 接线

```text
ROW2节点 -> 47kΩ -> U3 Pin2 / COL4 / c4
ROW3节点 -> 47kΩ -> U3 Pin6 / COL5 / c5
位置(2,5)与位置(3,4)不接
```

#### 数据目录

```text
data/rebuild_h2h3/20260818_015023_expB_run01/
```

#### 结果

```text
VREF估计：1032.535mV
ROW2-c4：1253.010mV
ROW2-c5：1033.835mV
ROW3-c4：1030.898mV
ROW3-c5：1254.265mV
Kghost_c4：0.743%
Kghost_c5：0.586%
```

#### 判定

双对角目标正确出现，两个空交叉点 ghost 均远低于 5% 判据。H3 实验B通过。

#### SVG图件

```text
data/rebuild_h2h3/20260818_015023_expB_run01/figures/h3_heatmap_exp_b.svg
data/rebuild_h2h3/20260818_015023_expB_run01/figures/h3_local_response_bar.svg
```

#### 下一步

进入实验C：四个位置全部接入 47kΩ，即补上：

```text
ROW2节点 -> 47kΩ -> U3 Pin6 / COL5 / c5
ROW3节点 -> 47kΩ -> U3 Pin2 / COL4 / c4
```

---

### 记录 #016 - H3实验C正式通过，A/B/C总体验收通过

**时间：2026-08-18 01:54 +08:00**  
**状态：PASS**

#### 接线

```text
ROW2节点 -> 47kΩ -> U3 Pin2 / COL4 / c4
ROW2节点 -> 47kΩ -> U3 Pin6 / COL5 / c5
ROW3节点 -> 47kΩ -> U3 Pin2 / COL4 / c4
ROW3节点 -> 47kΩ -> U3 Pin6 / COL5 / c5
```

#### 数据目录

```text
data/rebuild_h2h3/20260818_015409_expC_run01/
```

#### 实验C结果

```text
VREF估计：1032.591mV
ROW2-c4：1214.394mV
ROW2-c5：1217.387mV
ROW3-c4：1188.217mV
ROW3-c5：1190.829mV
四目标最小Delta：155.627mV
非目标行 c4/c5 最大偏离：5.046mV
```

#### H3总体验收

```text
实验A：PASS，Kghost_local = 0.583%
实验B：PASS，Kghost_c4 = 0.743%，Kghost_c5 = 0.586%
实验C：PASS，四目标均正确出现
H3总体：PASS
```

#### 汇总SVG图件

```text
data/rebuild_h2h3/h3_abc_summary_20260818_015409/figures/h3_abc_heatmaps.svg
data/rebuild_h2h3/h3_abc_summary_20260818_015409/figures/h3_abc_local_response.svg
data/rebuild_h2h3/h3_abc_summary_20260818_015409/figures/h3_abc_ghost_coefficient.svg
```

#### 下一步

H3 已完成并通过。等待监工验收，不自行进入 H4。

---

### 记录 #017 - H4真实传感器多点补测重新分析

**时间：2026-08-18 10:47 +08:00**  
**状态：READY_FOR_H4_REVIEW / 多点可分辨，局部坐标需标注**

#### 数据目录

```text
data/rebuild_h4/20260818_real_sensor_run01/
```

#### 用户给定多点按压目标

```text
(1,2)
(4,6)
(6,2)
```

#### 分析结果

```text
R1C2：Delta=867.573mV，SNR=536.9
R4C6：Delta=13.942mV，SNR=8.3
R6C2：Delta=234.869mV，SNR=140.1
```

实际峰值排名：

```text
R6C1：Delta=889.678mV
R3C6：Delta=878.151mV
R1C2：Delta=867.573mV
R6C2：Delta=234.869mV
```

#### 判定

多点补测显示多个独立响应区域，满足“多点可分辨”的展示目的。但 `(4,6)` 的强响应落在相邻 `R3C6`，`(6,2)` 的最大响应落在相邻 `R6C1`，需要在展示图中区分：

```text
intended press point
actual peak pixel
```

#### SVG图件

```text
data/rebuild_h4/20260818_real_sensor_run01/figures/multi_press_known_points_delta_heatmap.svg
data/rebuild_h4/20260818_real_sensor_run01/figures/multi_press_known_points_timeseries.svg
```

---

### 记录 #018 - H4物理显示坐标映射确认

**时间：2026-08-18 10:50 +08:00**  
**状态：DISPLAY_MAPPING_CONFIRMED**

#### 用户确认

```text
右下角坐标是 COL0 ROW7
右上角是 COL0 ROW0
```

#### 推导结果

```text
raw ROW0 -> 物理上侧
raw ROW7 -> 物理下侧
raw COL0 -> 物理右侧
raw COL7 -> 物理左侧
transpose = false
```

#### 最终显示映射

```text
row_origin = top
col_origin = right
transpose = false
```

#### 重新分析命令

```powershell
python tools/analyze_rebuild_h4.py data/rebuild_h4/20260818_real_sensor_run01 --row-origin top --col-origin right --multi-points "1,2 4,6 6,2"
```

#### 结果变化

raw 数据不变，展示图仅在显示层左右翻转 COL，使 `COL0` 出现在图的右侧。后续 ARCH-04 PPT 图均使用该版本。
