Dreamdealer1-crypto/forceSensor_8x8/reports/figures/phase2/receptive_field/E2_overlap_diagram.png

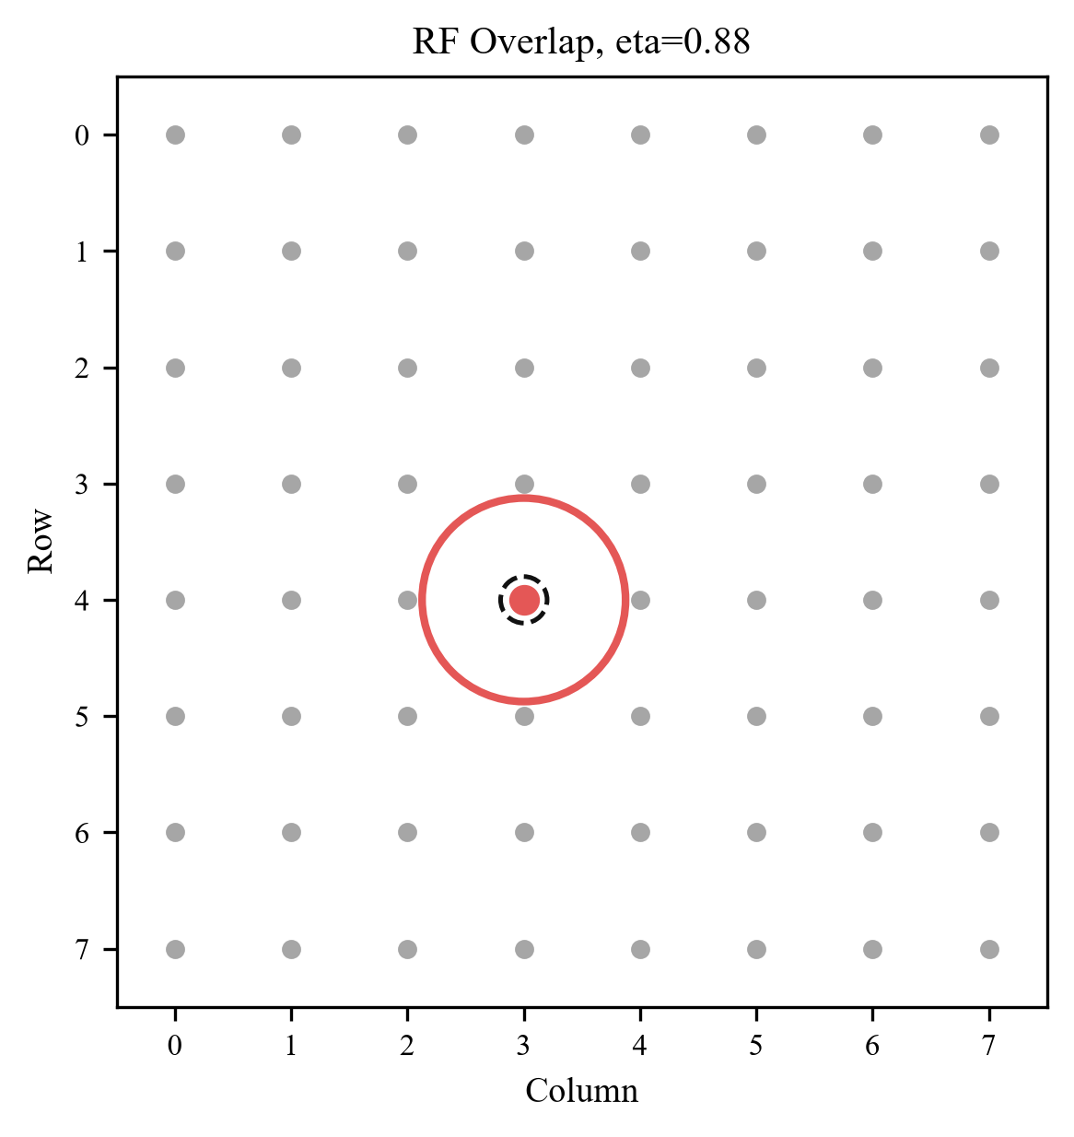
reports/figures/phase2/receptive_field/E2_overlap_diagram.png
