Dreamdealer1-crypto/forceSensor_8x8/reports/figures/phase2/receptive_field/E2_rf_2d_map.png

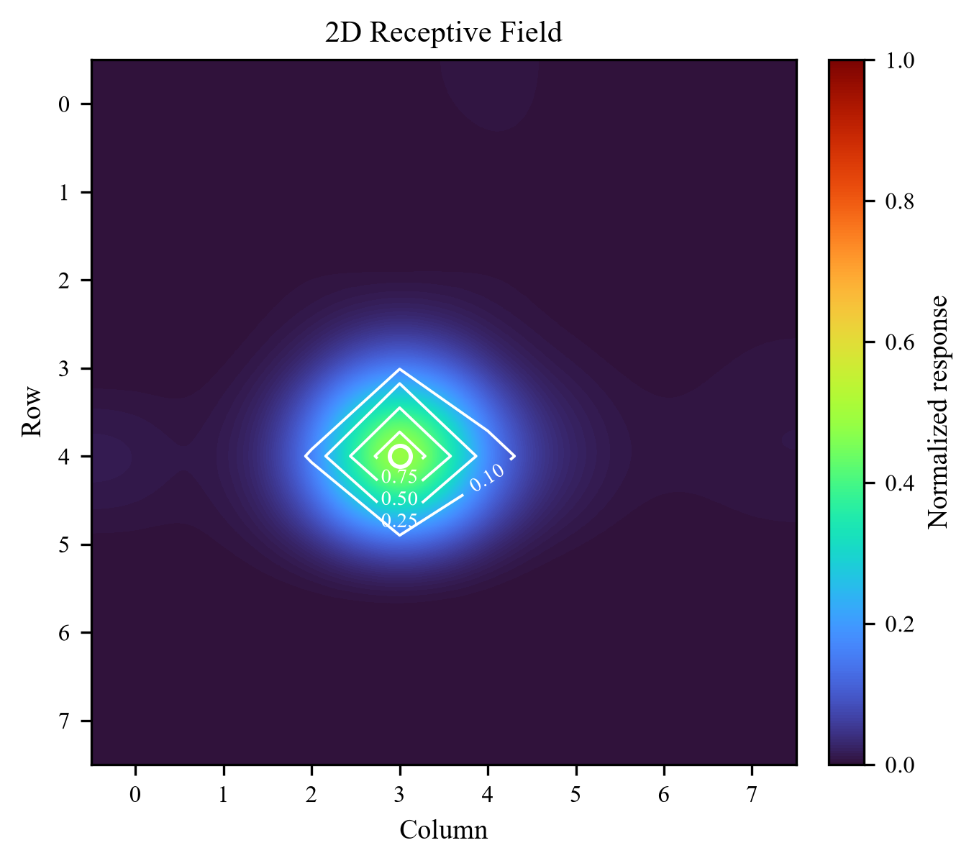
reports/figures/phase2/receptive_field/E2_rf_2d_map.png
